tristanlee85/canode/validation/reports/2026-11-09_sim.md

# Step 6: Analog simulation (2026-11-09)

> **Update (same day):** T approved the protection redesign, and it is now on the board: SMCJ33A, R17 10 Ω + C1 10 µF, R18 2.2 Ω. Results for the board as it now stands are the `*_new` cases in `run_all.py`, written up in [`2026-11-09_protection.md`](2026-11-09_protection.md). This report describes rev A *before* that change. One correction to it: the TI LDO model's internal ~1 µF input capacitor flattered the "SMBJ33A" pulse-2a rows below. That is why the SMC part was chosen.

**Result: FAIL on load dump, CONCERN on reverse battery, PASS on the divider and LDO start-up.**
The main problem is not the 30 V PTC or the 30 V FET. It is **D3 (SMBJ24A)**: its breakdown (26.7–29.5 V)
sits below the 35 V suppressed load dump that modern cars present, so it tries to clamp that dump and
takes 16–49 J, several times what an SMB package can absorb. Raising D3's breakdown fixes that, but
it pushes the transient clamp voltage up, and then Q1, the Schottkys and the LDO need more headroom.
See [Recommendations](#recommendations).

What was simulated is **rev A as committed** (`hardware/generator/design.py` at `0b6a452`). The
working-tree schematic already has Q1 = AO3422 (55 V) and D7 = SS36 (uncommitted, made by someone
else); the 55 V-FET what-ifs below cover that change.

## Verdicts

| # | Simulation | Verdict | Why |
|---|---|---|---|
| 1 | Reverse battery (−14 V) | **CONCERN** | D1 blocks (VIN −0.06 V), MCU pins are safe and F1 sees only 13.2 V once tripped. Two marginal points: the fault current of 39 A (43 A from a stiff source) is at or over F1's 40 A Imax, and **Q1's body diode carries 14.6 A / 20 W / 114 mJ via D7** until F1 trips, against a 2 A rating. |
| 2a | Load dump, unsuppressed (87 V / 1 Ω, 300 ms) | **FAIL** | VIN 48.8 V (above the LDO's 45 V abs max for 7 ms); D3 gets 3–9× its energy allowance; **F1 blocks 55–84 V for ~290 ms (2.8× its 30 V rating)**; Q1 avalanches (up to 61 W with a 24 Ω load); PA1 reaches 7.9 V (above the 7.3 V abs max). No SMB-class part survives this. |
| 2b | Load dump, suppressed (35 V clamp, Ri 0.5–4 Ω, 400 ms) | **FAIL** (D3) | D3 conducts 1.4–5.3 A, 40–163 W, **16–49 J, 1.1–3.7× even an optimistic SMB allowance.** F1 sees ≤ 8 V (PASS). Q1 VDS 30.6–31.6 V for up to 400 ms (**+5 % over its rating**, CONCERN). LDO 31.5 V (PASS). |
| 3 | VBAT divider | **PASS** | Gain 0.09089 (1/11), 0.5 LSB settling in 7.3 ms. PA0 ≤ 2.9 V in every survivable case. In test A only, PA0 reaches 4.3 V (above VDD + 0.3 V but within the FT-pin limits; the reading saturates). The AUX_IN copy of the divider has no TVS: see sim 2a. |
| 4 | LDO start-up (TI model, real caps) | **PASS** | +3V3 rises to 3.0 V in 79 µs with no overshoot. Hot-plug ringing reaches 16.4 V. Inrush peaks at 8.6 A for µs. Regulation holds through a 4.5 V crank dip. |
| + | ISO 7637-2 pulse 2a, 112 V / 2 Ω (supplementary) | **CONCERN** | As built, VIN reaches 44.3 V: above the LDO's 40 V operating limit and 0.7 V under its 45 V abs max. D2 (SS34, 40 V) sees about 44 V reverse. Run because it decides the TVS choice. |

### The question asked: are the 30 V PTC and FET exposed above their rating?

| Event | F1 PTC (30 V, Imax 40 A) | Q1 AO3400A (30 V, no avalanche rating) |
|---|---|---|
| Reverse battery −14 V | **No.** 13.2 V across F1 after trip. But Imax is the issue: 39.3 A peak from a 50 mΩ source, 43.2 A from 20 mΩ (8 % over). | **No overvoltage**, but its body diode sits in parallel with D3's forward path (via D7): 14.6 A peak, 20 W, 114 mJ for about 12 ms. That pulse is unrated. |
| Suppressed load dump (35 V) | **No.** At most 8.1 V across it, because D3 holds VBATF at about 28–31 V. *This is only true while D3 survives.* If D3 fails short (likely, see 2b), F1 trips and blocks the full 35 V: **+17 %**. | **Yes, by 0.6–1.6 V (+2–5 %)** for up to 400 ms: VDS = VBATF + V(D7) = 30.6–31.6 V. That is leakage-level unless BVDSS is near 31 V (then 0.15 J of avalanche). |
| Unsuppressed load dump (87 V) | **Yes, by 2.8×.** After tripping (2.7–8.6 ms) it blocks **55–84 V for about 290 ms**. | **Yes.** It avalanches at its BVDSS (34 V assumed) while VBATF is at 49 V. With a 24 Ω load: 1.8 A, 61 W peak, and > 30 V for the whole 300 ms. |

So the 30 V parts are only *grossly* exceeded in the unsuppressed dump, which no SMB-size design
survives anyway. In the suppressed dump, the one these cars actually present, Q1 is marginal (+5 %) and F1 is
fine *only because D3 is absorbing energy it cannot survive*.

## Setup

- `ngspice-47`, run in PSpice-compatibility mode (`-D ngbehavior=ps`), plus numpy and matplotlib.
- **Files** (all in `validation/sim/`):
  - `run_all.py`: runs every sim and prints the numbers. It also writes `out/summary.txt` and `out/sim*.png`.
  - `fetch_models.sh`: downloads the vendor models and checks each against a pinned sha256.
  - `board.inc`: rev A's power, sense and AUX netlist, transcribed from `design.py`.
  - `models.inc`, `models/canode.lib`: local derived and behavioral models.
  - Top-level netlists: `reverse_battery.cir`, `loaddump.cir`, `vbat_divider.cir`, `ldo_startup.cir`.
- **To run:** `source .venv/bin/activate && python validation/sim/run_all.py` (about 15 s).
  The raw `.dat` files total about 175 MB and are gitignored; PNGs and `summary.txt` are kept.
- **Vendor models are not committed.** TI marks its model "All rights reserved"; Vishay's carry a Thomatronik copyright with no redistribution grant. `.gitignore` excludes `validation/sim/models/vendor/`. I read each file before pinning its hash: all are plain `.SUBCKT`/`.MODEL` text with no `.control` blocks.

### Models and where they came from

| Part | Model | Source / approximation |
|---|---|---|
| U2 TPS7B6933-Q1 | **TI unencrypted PSpice transient model** `TPS7B6933-Q1_TRANS.lib` (WEBENCH, Dec 2014, "Final 1.00"), used unmodified | [ti.com/lit/zip/slvmcq7](https://www.ti.com/lit/zip/slvmcq7). Runs as-is in ngspice's PSpice mode. **It is behavioral**: no loop dynamics (so it can't check stability; that was checked against the datasheet instead), no thermal shutdown, no abs-max behavior, and dropout is modeled as a 4.66 Ω switch. Its UVLO is 4.0 V on / 3.0 V off; the datasheet says 3.65 V max rising and 3 V falling. |
| D1, D2, D7 SS34 | Vishay `ss34.txt` (Thomatronik), BV 44 V | [vishay.com/docs/88170/ss34.txt](https://www.vishay.com/docs/88170/ss34.txt) |
| D3 SMBJ24A | **Derived.** Vishay publishes SMBJ22A/30A/33A/36A models but not 24A. I used the same Thomatronik topology (`SMBJ_UNI` in `canode.lib`) refit to the SMBJ24A datasheet: VBR 28.1 V nominal (26.7–29.5), Rd = (38.9 − 28.1)/15.4 = 0.70 Ω | Vishay fit its own models the same way. Validation: `SMBJ_UNI` reproduces Vishay's SMBJ22A to 0.01 V and SMBJ33A to 0.07 V from 1 mA to IPP; the 24A fit gives 39.0 V at 15.4 A (datasheet 38.9 V). No self-heating: real VBR rises about 0.1 %/K during long pulses, so the long-pulse numbers slightly understate VBATF. |
| SMBJ33A / 36A (what-if) | Same subckt with Vishay's parameters (38.65 V / 1.30 Ω, 42.1 V / 1.54 Ω) | [smbj33a.txt](https://www.vishay.com/docs/88150/smbj33a.txt), [smbj36a.txt](https://www.vishay.com/docs/89579/smbj36a.txt) |
| Q1 AO3400A | **Fitted ngspice VDMOS.** AOS publishes no SPICE model. Fitted to the AOS datasheet (Rev 3.1, Jul 2023): Vth 1.05 V, 19 mΩ at 4.5 V, VSD 0.7 V at 1 A, Ciss/Coss/Crss, Rg 3 Ω | The datasheet gives only BVDSS ≥ 30 V and **no avalanche (EAS/IAS) rating**. I assumed **34 V** for the body-diode breakdown and ran a 31 V corner. For the 55 V what-if, `NFET_55V_OFF` is the same model with BV 58 V; it is not a fit of the AO3422. |
| F1 BSMD1206-050-30V | **Thermal behavioral PTC** (one RC, T in °C). R(T) = 0.25 Ω × (1 + ΔT/40) plus a polymer switch near 115–125 °C. Rth = 125 K/W, so the tripped state dissipates 0.8 W (the catalog Pd). | No vendor model, and the PDF datasheet couldn't be downloaded. Specs are from the LCSC/JLC listing: Ihold 0.5 A, Itrip 1 A, 30 V, Imax 40 A, Pd 0.8 W, R 0.15–0.85 Ω, trip ≤ 0.1 s (test current not printed; 8 A, the industry standard for this size, assumed). Calibrated corners: **slow** trips in 94.6 ms at 8 A (the datasheet maximum); **fast** trips in 29.7 ms. Both hold at 0.5 A (+10 K) and trip at 1 A. Arcing or breakdown above Vmax is not modeled. |
| PA0 / PA1 | Diode to VSS only, plus 5 pF | ST says positive injection is not possible on FT pins. Limits used: abs max VDDIO + 4.0 V = 7.3 V; normal operation ≤ min(VDD + 3.6 V, 5.5 V); negative injection −5 mA. Sources: the STM32G0B1/G0C1 datasheet tables (via the G0C1 text and an ST community answer; the G0B1 PDF wouldn't download). **Verify in DS13560 that PA0 and PA1 are FT_xx.** |
| Passives | Effective values after DC-bias derating: C1 0.8 µF; +3V3 total 11 µF (16.4 µF nominal); +3V3 load 165 Ω (about 20 mA) plus the power LED | From `design.py` part numbers |

### Model fixes and simulator limits (stated so they can be reproduced)

- **Run end times.** Each load-dump run stops 5 ms after its pulse ends. In unsuppressed cases with no AUX load, the board browns out behind the tripped PTC: the LDO hiccups in UVLO, which is physical (the PTC needs seconds to cool and reset). After the pulse, the TI model's ideal UVLO comparator makes the timestep collapse. Recovery isn't needed for any of the metrics. `run_all.py` now **fails loudly** if any run aborts. Earlier silent truncation was caught and fixed this way.
- **USB start-up edge.** The USB start-up uses a 100 µs VBUS edge. With a 1–5 µs edge, the TI model's internal 1 µF (behind its UVLO switch) charge-shares with C1, VIN dips back under UVLO, and the comparator chatters until ngspice aborts. That is a model artifact.
- **Rejected model patch.** I tried shrinking that internal capacitor to 10 nF in a working copy. It fixed the chatter but made the model pump VIN to 75 V during brown-out, which is not physical, so I reverted it. The vendor model is used exactly as published.
- **What the model can't check.** It has no IN-pin abs-max behavior. The LDO's input exposure is therefore reported as the VIN voltage versus the datasheet limits: **40 V operating, 45 V abs max, "withstands 45 V for 200 ms"** (SLVSCJ8B, verified).

## Sim 1: reverse battery

**Model.** At t = 1 ms, −14 V is applied at J2-1 from a 50 mΩ source (battery plus harness) through 1 µH. AUX_IN is wired to the same reversed feed. Cases: no AUX load, an 85 Ω / 0.2 H relay, a 12 Ω lamp, a stiff 20 mΩ source, the fast PTC corner, and a what-if with 2.2 Ω in series with D7. Plot: `out/sim1_reverse_battery.png`.

| | F1 peak | Trip after reversal | I²t | D3 forward | Q1 body diode (via D7) | F1 after trip |
|---|---|---|---|---|---|---|
| Slow PTC (worst) | **39.3 A** | 12.3 ms | 6.0 A²s | 24.7 A, 0.29 J | **14.6 A, 20 W, 114 mJ** | 13.2 V, 58 mA |
| Fast PTC | 39.0 A | 3.9 ms | 1.9 A²s | 24.5 A, 0.10 J | 14.5 A, 36 mJ | 13.2 V |
| Stiff source (20 mΩ) | **43.2 A** (> 40 A Imax) | 11.1 ms | 6.0 A²s | 27.0 A | 16.3 A, 23.5 W | 13.2 V |
| 12 Ω lamp on AUX_OUT | 39.1 A | 12.5 ms | | 24.9 A | 15.1 A, then **1.11 A continuous** (lamp current; about 0.9 W in Q1 indefinitely) | 13.0 V |
| What-if: 2.2 Ω in series with D7 | 37.8 A | 12.9 ms | | 37.0 A, 0.56 J | **0.74 A, 4 mJ** | 13.1 V |

**Minimum voltages** (slow corner):

| Node | Minimum | Assessment |
|---|---|---|
| VBATF | −2.16 V | D3's forward drop at 25 A |
| VIN | −0.06 V | D1 blocks; the LDO's abs min is −0.3 V |
| +3V3 | 0 V | |
| PA0 | −0.16 V | |
| PA1 | −0.59 V | Clamped by the pin diode with −0.13 mA injected, within the −5 mA limit |
| AUX_OUT | −1.39 V | Q1 body diode |

**Assessment.**
- Everything the plan asked about passes: D1 blocks, D3 conducts within its ratings (IFSM 100 A), F1 trips in 4–12 ms, and nothing on the MCU side goes below −0.5 V except PA1, which is within its injection limit.
- Two concerns remain.
  - **F1's 40 A Imax is reached or exceeded.** The fault current is set only by the source and harness resistance plus F1's own 0.25 Ω.
  - **Q1's body diode and D7 form a second reverse path** in parallel with D3's forward drop, because VBATF sits 2.2 V below ground. A 2.2 Ω resistor in series with D7 cuts that path to 0.74 A. It costs +0.3 V on normal relay flyback (simulated: VDS 14.1 V vs 13.8 V).

## Sim 2: load dump (Q1 off)

**Model.**
- **Generator:** 13.5 V baseline stepping to US through Ri. The "vehicle bus" node after Ri feeds J2-1 (20 mΩ + 1 µH), AUX_IN, and the external AUX_OUT load.
- **Test A** (unsuppressed): 87 V / 1 Ω, flat top for 300 ms (the plan's worst case), plus an ISO-like shape (10 ms rise, decaying to 10 % at 300 ms).
- **Test B** (suppressed, ISO 16750-2): the same pulse clamped to Us* = 35 V before Ri, with Ri = 0.5 / 1 / 4 Ω and 400 ms (the longest td).
- **TVS rating comparison:** 600 W for 10/1000 µs equals 0.87 J over an equivalent 1.44 ms. For longer pulses the allowance is scaled with √t (adiabatic). That is an optimistic extrapolation of the datasheet Ppk–td curve beyond 10 ms (SMBJ steady-state dissipation is only a few watts), so exceeding it is a clear fail and staying under it is not proof of survival.
- **Plots:** `out/sim2_loaddump_unsuppressed.png`, `out/sim2_loaddump_suppressed.png`.

### Test A: unsuppressed

| Case | VBATF pk | VIN pk (> 45 V) | F1: Ipk / trip / V blocked | D3: Ppk / E / vs allowance | Q1 VDS (Id) | PA0 / PA1 |
|---|---|---|---|---|---|---|
| Flat, slow PTC | 49.1 V | **48.8 V (7.1 ms)** | 30.3 A / 8.6 ms / **83.8 V for 292 ms** | 1461 W / 10.7 J / **5.5×** | 34.0 V (µA) | 4.28 / **7.91 V** |
| Flat, fast PTC | 49.0 V | 48.8 V (2.2 ms) | 30.2 A / 2.7 ms / 83.8 V | 1457 W / 3.4 J / **3.1×** | 34.0 V | 4.01 / 7.91 V |
| ISO shape | 47.7 V | 47.5 V (1.4 ms) | 27.9 A / 19.4 ms / 42.3 V | 1330 W / 13.0 J / **5.8×** | 33.9 V | 4.17 / 6.38 V |
| + 85 Ω relay on AUX_OUT | 49.1 V | 48.8 V | 30.2 A / 8.6 ms / 57.7 V | 16.3 J / **6.8×** | 34.2 V, 0.33 A, 11 W | |
| + 24 Ω load on AUX_OUT | 48.7 V | 48.5 V | 29.7 A / 8.9 ms / 54.9 V | 30.5 J / **9.2×** | 34.3 V for 300 ms, 1.8 A, **61 W** | |
| What-if D3 = SMBJ33A | 63.1 V | **62.9 V (21 ms)** | 19.7 A / 20 ms / 83.8 V | 21.6 J / 7.0× | 34.0 V | **5.66 V** / 7.91 V |

Note the AUX_OUT load cases. Once F1 trips, the **external load plus D7 form an unfused path from the
bus into VBATF and D3**. F1 does not protect D3 when something is wired to AUX_OUT, which is why D3's
energy doubles or triples.

A hand calculation for what a real test-A clamp would have to absorb: 87 V, Ri 1 Ω, the ISO shape
with td 300 ms, into a 35 V clamp, comes to about **120 J**. That is DO-218 load-dump-TVS territory or
an active surge stopper, not an SMB.

### Test B: suppressed (35 V)

| Case | VBATF pk | VIN pk | F1: Ipk / trip / V across | D3: I / Ppk / E / vs allowance | Q1 VDS (time > 30 V) |
|---|---|---|---|---|---|
| Ri 0.5 Ω, slow PTC | 31.4 V | 31.5 V | 4.7 A / 394 ms / 5.4 V | 4.6 A / 146 W / **48 J / 3.7×** | **31.4 V (392 ms)** |
| Ri 0.5 Ω, fast PTC | 31.5 V | 31.5 V | 4.7 A / 123 ms / 6.7 V | 146 W / 15.9 J / **2.1×** | 31.4 V (123 ms) |
| Ri 1 Ω | 30.6 V | 30.6 V | 3.5 A / no trip / 1.7 V | 106 W / 39 J / **2.8×** | 30.6 V (399 ms) |
| Ri 4 Ω | 29.2 V | 29.6 V | 1.4 A / no trip / 0.4 V | 40 W / 15.7 J / **1.1×** | 29.1 V |
| D3 at VBR min (26.7 V) | 31.0 V | 31.1 V | 5.3 A / 297 ms / 8.1 V | 163 W / 41.5 J / 3.6× | 30.9 V (250 ms) |
| + relay on AUX_OUT | 31.4 V | 31.5 V | 4.7 A / 397 ms / 4.7 V | 48.6 J / 3.7× | 31.6 V (397 ms) |
| + relay, Q1 BVDSS 31 V | 31.5 V | 31.5 V | | 48.5 J | 31.1 V, avalanche 0.7 W, 0.15 J |
| **What-if D3 = SMBJ33A** (+ relay) | 35.3 V | 36.0 V | 1.0 A (board only) / no trip / 0.3 V | **0 A** | 34.1 V: AO3400A avalanches (0.14 J) |
| **What-if SMBJ33A + 55 V FET** | 35.0 V | 34.8 V | no trip | **0 A** | 35.1 V, no avalanche |
| What-if D3 = SMBJ36A | 35.3 V | 36.0 V | no trip | 0 A | 34.1 V |

Across the whole ISO Ri range (0.5–4 Ω), SMBJ24A takes 16–49 J during a 35 V suppressed dump, and
**the PTC doesn't save it**: at Ri ≥ 1 Ω the PTC never trips within 400 ms. With D3's breakdown above
35 V (SMBJ33A or 36A), D3 carries nothing, F1 doesn't trip, VIN stays at 36 V (within the LDO's 40 V
operating limit), and only Q1 needs more than 35 V of rating.

### Supplementary: ISO 7637-2 pulse 2a (+112 V on 13.5 V, Ri 2 Ω, tr 1 µs, td 50 µs)

| Case | VBATF pk | VIN pk | Q1 VDS | +3V3 max |
|---|---|---|---|---|
| As built (SMBJ24A) | 44.8 V | **44.3 V** (> 40 V operating, 0.7 V under the 45 V abs max) | 34.1 V (AO3400A at BV, µs) | 3.62 V |
| As built, 55 V FET, relay | 44.8 V | 44.3 V | 42.9 V | |
| D3 = SMBJ33A | 54.0 V | **53.6 V (> 45 V abs max)** | | 3.69 V |
| SMBJ33A + 55 V FET, relay | 54.0 V | 53.6 V | **53.8 V (2 % under 55 V)** | |
| SMBJ33A + 10 Ω (D1→VIN) + C1 = 8 µF effective | 61.5 V | **23.6 V** | VBATF + Vf ≈ 62 V | 3.37 V |
| 50 V level, as built | 33.2 V | 32.7 V | 31.6 V | |

D3 energy is negligible in every row (≤ 0.02 J). What matters is the clamp *voltage*. Raising D3's
breakdown to clear 35 V puts about 54 V on VBATF and VIN at the harshest 2a level. The +3V3 bumps come
from the TI model's behavioral PSRR (indicative only; the STM32's VDD abs max is 4.0 V). As built,
**D2 (SS34, 40 V) is reverse-biased to about 44 V** (VIN against an unpowered VBUS), and the same
applies to D7 when Q1 is on.

## Sim 3: VBAT divider

**Model.** The board netlist with an ideal supply on VBAT_IN, so F1's drop is included. A DC sweep from 0 to 26 V (above that, D3 conducts and a DC sweep stops being meaningful), plus a 0 → 14 V step. Plot: `out/sim3_vbat_divider.png`.

| VBAT | 9 V | 12 V | 13.5 V | 14.4 V | 16 V | 24 V |
|---|---|---|---|---|---|---|
| PA0 (V) | 0.818 | 1.090 | 1.227 | 1.309 | 1.454 | 2.181 |
| ADC code (3.3 V ref) | 1015 | 1353 | 1523 | 1624 | 1805 | 2707 |

- **Gain:** 0.09089 (ideal 1/11 = 0.09091; the difference is F1's drop at 20 mA).
- **Settling:** τ = 9.09 kΩ × 100 nF, 0.91 ms (63 % in 0.91 ms, simulated). **0.5 LSB in 7.3 ms.**
- **ADC kickback:** with a 100 nF hold cap, the ADC's ~5 pF sampling cap disturbs the input by < 0.2 LSB, so any sampling time works.

**Peak PA0 and PA1 during the load-dump runs:**

| Event | PA0 (VBAT) | PA1 (AUX_IN on the bus) |
|---|---|---|
| Test B, any case | **2.86 V**, under VDD | 3.1–3.2 V |
| Test B with D3 = SMBJ33A | 3.18 V (35 V reads about 3950 counts, still in range) | 3.18 V |
| Test A | 4.0–4.3 V: above VDD + 0.3 = 3.6 V, below the 5.5 V operating and 7.3 V abs-max limits; reading saturates above 36.3 V | **7.9 V > 7.3 V abs max.** AUX_IN has no TVS; 9.1 kΩ Thevenin limits it to < 0.5 mA, but FT pins don't allow positive injection, so the pin voltage just rises |
| Pulse 2a | ≤ 1.37 V | ≤ 1.37 V (filtered by the 100 nF) |

**Verdict: PASS** for the VBAT divider, including VDD + 0.3 V in every survivable event. Test A is
the only exceedance, and the board doesn't survive test A anyway.

## Sim 4: LDO start-up (TI model, real caps)

| Case | VIN pk | Inrush pk | +3V3: 10–90 % / to 3.0 V | +3V3 max | Notes |
|---|---|---|---|---|---|
| 12 V hot-plug, 1 µH lead | 15.7 V (VBATF 16.1 V) | 8.6 A (µs, C1/C2 through D1) | 67 µs / 79 µs | 3.308 V | No overshoot; ringing below D3's VBR |
| 12 V hot-plug, 3 µH lead | 16.4 V | 5.8 A | 67 µs / 80 µs | 3.308 V | |
| USB 5 V (100 µs edge) | 4.8 V | | 69 µs / 164 µs from start of edge | 3.301 V | VIN = VBUS − D2 = 4.76 V |
| 12 V slow ramp, 10 ms | 11.8 V | 0.93 A | starts at VBAT ≈ 4.3 V (3.57 ms) | 3.308 V | The model's UVLO is 4.0 V; the real part's is ≤ 3.65 V |
| Crank dip to 4.5 V, 30 ms | | | | min 3.300 V | VIN min 4.26 V. The datasheet's worst dropout (0.8 V at 50/100 mA) still leaves ≥ 3.3 V |
| Start-stop dip to 6.0 V | | | | min 3.302 V | |

- **Capacitors:** effective +3V3 capacitance is 11 µF (the datasheet needs 2.2–100 µF effective, ESR < 2 Ω) ✔. Input caps C1 + C2 are 1.1 µF nominal (the datasheet recommends > 0.1 µF) ✔.
- **Stability:** loop stability can't be simulated with this behavioral model; the datasheet requirements above are met.
- **Verdict: PASS.**

## Recommendations

Electrical requirements only; sourcing is being handled separately.

1. **Design target: ISO 16750-2 test B (35 V suppressed), not test A.**
   - Modern vehicles like the targets clamp load dump centrally. Test A would need about 120 J of clamping (DO-218-class load-dump TVS) and an F1 rated ≥ 100 V, or an active surge stopper / OV-disconnect with a ≥ 100 V series FET.
   - Say in the README that the board is not test-A rated.
2. **Change D3 now. This is the actual failure.**
   - **Requirement:** VBR(min) ≥ 36 V, so D3 doesn't conduct at 35 V, and standoff ≥ 26 V for jump-start (SMBJ24A sits right at its 24 V standoff during a 24 V jump).
   - **Candidate:** an SMBJ33A-class part (VBR 36.7 V min, VC 53.3 V at 11.3 A) meets this. Simulated: **0 A in test B** and only 0.01 J on pulse 2a.
   - Keep it unidirectional: the forward clamp is what handles reverse battery and negative pulses.
3. **Everything on VBATF, VIN and AUX_OUT must then handle about 54 V transients** (62 V if C1 is moved behind a series resistor) and 35 V DC for 400 ms:
   - **Q1:** VDS ≥ 60 V, preferably avalanche-rated (EAS specified). The 55 V AO3422 in the working tree is enough with SMBJ24A (42.9 V on pulse 2a), but has only 2 % margin with SMBJ33A (53.8 V). Separately, either the body diode must be rated for a ~15 A, 15 ms pulse, **or add 2.2 Ω (0805) in series with D7**, which cuts the reverse-battery current through Q1 from 14.6 A to 0.74 A.
   - **D1, D2, D7:** VRRM ≥ 60 V. D2 is already at 44 V reverse on pulse 2a as built. D7 → SS36 is already in the working tree; D2 needs the same.
   - **LDO**, either of:
     - (a) VIN abs max ≥ 60 V; or
     - (b) keep the TPS7B69 (40 V operating / 45 V abs) behind **10 Ω from D1 to VIN plus ≥ 8 µF effective at 35 V on VIN** (two 10 µF / 50 V 1210 X7R, or an electrolytic). Simulated VIN on pulse 2a: 23.6 V. Cost: 0.2–0.6 V of drop at 20–60 mA; the 4.5 V crank case still regulates.
     - In test B with SMBJ33A, VIN = 36 V, within 40 V either way.
4. **F1 to 60 V: lower priority than D3 and Q1, but cheap insurance.**
   - With D3 fixed per (2), F1 never trips from a load dump. Its worst voltage is then 13.2 V (reverse battery), so 30 V is technically enough.
   - Reasons to change it anyway:
     - A downstream short during a 35 V event puts 35 V across it.
     - Its **40 A Imax is reached in reverse battery** (39–43 A).
   - **Requirement:** Vmax ≥ 36 V minimum (60 V preferred), Imax ≥ 50 A, Ihold 0.5 A / Itrip ≈ 1 A.
5. **AUX_IN (optional):** fine for test B. To survive more, raise R13 or add a clamp at AUX_SENSE.
6. **Bottom line on "swap to 60 V parts now?"** Yes, for **Q1 and the Schottkys**, *together with* the D3 change. **On its own, swapping F1 and Q1 to 60 V while keeping SMBJ24A does not fix the real failure** (D3 overstress in the 35 V dump). Changing D3 alone, without the downstream ratings, moves the failure to Q1, D2 and the LDO on fast pulses.

## Proposed Makefile target (not added; Makefile is the lead's)

```make
sim:                           ## analog sims (ngspice) -> validation/sim/out/summary.txt + plots
	$(PY) validation/sim/run_all.py
```
(Add `sim` to `.PHONY`. Needs `ngspice` on PATH and numpy/matplotlib in the venv; the vendor models download on the first run. `make check` could include it; the run takes about 15 s.)
