tristanlee85/canode/validation/reports/2026-11-09_drc.md

# Step 4: Board DRC + schematic parity (2026-11-09)

**Result: PASS.** 0 errors, 0 unconnected pads, schematic parity clean.
51 warnings remain, all `lib_footprint_mismatch`, reviewed and left as-is (below).

Tool: KiCad 10.0.8 `kicad-cli pcb drc --severity-all --schematic-parity` (`make drc`).

## First run (before fixes)
| Type | Count | Severity | Outcome |
|---|---|---|---|
| `clearance` | 1 | error | **Fixed**: via moved |
| `starved_thermal` (U5 pin 2) | 1 | error | **Fixed**: solid zone connection |
| `silk_overlap` (C5 / Y1 reference text) | 1 | warning | **Fixed**: Y1 label moved |
| `net_conflict` | 199 | warning | **Fixed**: nets renamed to schematic names |
| `footprint_symbol_field_mismatch` | 20 | warning | **Fixed**: fields synced |
| `footprint_symbol_mismatch` (BOM flag) | 6 | warning | **Fixed**: intent set in schematic / board |
| `lib_footprint_mismatch` | 51 | warning | Left as-is |

The stored zone fill was current before any change: DRC with `--refill-zones` gave identical results.

## Changes made
All were tested on a scratch copy first, then applied. Afterwards: `make check` (pins 28/28, ERC 0 errors, DRC 0 errors, parity clean) and `make fab` (CPL identical to the committed rev A one, so no part moved).

1. **Clearance (0.157 mm, rule 0.2 mm):** GND stitching via (no tracks attached) next to the 0.5 mm VBATF track moved
   from (106, 133) to **(105.8, 132.8)**, giving ~0.37 mm clearance. Four other candidate positions were also clean.
2. **Starved thermal, U5 pin 2 (GND):** pad zone connection set to **solid**. Normal for a reflowed SOIC ground pin.
3. **Silk overlap:** Y1 reference label moved 2.2 mm left. (Trialled 7 positions; others hit pads or C6.)
4. **Format upgrade:** `kicad-cli sch|pcb|sym upgrade`. Schematic, board and project symbol library are now KiCad 10 format.
5. **Net names (`net_conflict`):** the generator named board nets `VIN`, `GND`, …; KiCad names local-label nets `/VIN`, ….
   All 45 board nets were renamed to the names in KiCad 10's own netlist export (every board net had an exact `/`-prefixed match).
   The 24 schematic no-connect pins got their `unconnected-(…)` net names via KiCad's Python API (`pcbnew`, bundled with KiCad 10).
6. **Net-class trap, fixed first:** the net-class patterns were exact names (`VBATF`, `VIN`, `GND`, …). Tested on a scratch copy:
   renaming VBATF to `/VBATF` made the pattern stop matching. VBATF silently fell back to the Default class (0.15 mm), and the
   clearance error *disappeared without being fixed*. So `/`-prefixed patterns were added for all seven power/supply nets
   in `canode.kicad_pro` (old ones kept). Verified: the clearance error still reported with the new names until the via was moved.
7. **Footprint fields:** Datasheet, LCSC, MPN and JLC fields copied from the symbols to the footprints (what F8 does), via `pcbnew`.
8. **BOM flags:** the board excluded J2–J5 and JP1/JP2 from the BOM; the schematic included all six. Resolved by intent:
   J2–J5 are real purchased connectors (now in BOM on both sides); JP1/JP2 are bare-copper solder jumpers with nothing to buy
   (schematic set to `in_bom no`). The JLC files are unaffected: `jlc_fab.py` selects assembled parts by the `LCSC` field.

Because of 5, 7 and 8, *Update PCB from Schematic* (F8) currently has nothing left to do.

## Warnings left as-is: `lib_footprint_mismatch` (51)
The board uses footprints embedded from the KiCad 7 libraries; KiCad 10's libraries have changed since. Same situation as the
symbols in the ERC report. **Don't run *Update Footprints from Library*** without first checking pad numbering and geometry
for each part.

## Fab output note
`make fab` output differs from the committed `hardware/fab/` only in descriptive text (the committed BOM / hand-solder files were
hand-tidied after generation, e.g. "Tactile switch" vs. the symbol value "RESET"). LCSC numbers, designators and the CPL are identical.
