tristanlee85/canode/validation/reports/2026-11-09_lcsc.md

# Step 9: LCSC / JLC stock and price, plus part-upgrade recommendations (2026-11-09)

**Result: ❌ NOT orderable as-is.** Three BOM lines have **0 stock** at both JLC and LCSC:
- **U1 STM32G0B1CBT6**
- **D3 SMBJ24A** (FMS, C143156)
- **D5 yellow LED** (C72038)

One more line is low: **U2 TPS7B6933QDCYRQ1, 59 pcs**.

D3 and D5 have easy drop-in replacements. U1 does not.

## How the data was gathered
- **JLC:** the JSON endpoints behind jlcpcb.com/parts. `selectSmtComponentList` gives library type (`base` = Basic, `expand` = Extended), the `preferredComponentFlag` and stock. `getComponentDetail` gives the brand, MPN and datasheet. Both were queried 2026-11-09.
- **LCSC:** `wmsc.lcsc.com/ftps/wm/product/detail`, which gives LCSC's own stock and price ladder.
- **Price @10:** JLC's 1–199 tier in USD, which is what JLC assembly charges per part.
- Neither site blocked these queries. Product pages: `https://www.lcsc.com/product-detail/<C#>.html`, `https://jlcpcb.com/parts/componentSearch?searchTxt=<C#>`.
- Stock changes daily, so re-check on the day you order.

## BOM lines
| Ref | Part (the actual MPN at that LCSC #) | LCSC # | JLC class | JLC stock | LCSC stock | $ @10 | Flag |
|---|---|---|---|---|---|---|---|
| C1 | Samsung CL21B105KBFNNNE 1 µF 50 V 0805 | C28323 | Basic | 4,125,668 | 506,100 | 0.0280 | |
| C2,C4,C5,C7,C9,C12–C14,C16,C17 | **YAGEO CC0603KRX7R9BB104** 100 nF 50 V X7R | C14663 | Basic | 33,392,876 | 67,800 | 0.0060 | BOM note says CL10B104KB8NNNC; the real part is an equivalent YAGEO. Fix the note. |
| C3 | **Samsung CL10A106MA8NRNC 10 µF 25 V** X5R 0603 | C96446 | Basic | 6,682,748 | 2,051,780 | 0.0346 | BOM note says CL10A106MQ8NNNC (6.3 V); the real part is rated 25 V, which is better. Fix the note. |
| C6, C15 | Samsung CL21A475KAQNNNE 4.7 µF 25 V X5R 0805 | C1779 | Basic | 1,745,984 | 199,740 | 0.0342 | |
| C8 | Samsung CL10A105KB8NNNC 1 µF 0603 | C15849 | Basic | 12,755,045 | 539,700 | 0.0109 | |
| C10, C11 | FH 0603CG300J500NT 30 pF C0G | C1658 | Basic | 395,734 | 90,800 | 0.0051 | Proposed change to 20 pF (step 7) |
| D1, D2, D7 | MDD SS34 | C8678 | Basic | 3,000,794 | 2,174,640 | 0.0351 | |
| **D3** | FMS SMBJ24A (uni) | C143156 | Extended | **0** | **0** | 0.0738 | ❌ **Out of stock** |
| D4 | KENTO KT-0805G green | C2297 | Basic | 1,929,972 | 1,037,200 | 0.0164 | |
| **D5** | Everlight 19-213/Y2C-CQ2R2L/3T yellow | C72038 | Extended | **0** | **0** | 0.0239 | ❌ **Out of stock**; also no longer Basic |
| D6 | KENTO KT-0603R red | C2286 | Basic | 6,532,831 | 4,019,600 | 0.0077 | |
| F1 | BHFUSE BSMD1206-050-30V | C883126 | Extended | 92,935 | 91,140 | 0.0599 | Upgrade proposed (30 V) |
| J1 | HRO TYPE-C-31-M-12 | C165948 | Extended | 311,218 | 291,175 | 0.1868 | |
| Q1 | AOS AO3400A | C20917 | Basic | 1,039,675 | 463,345 | 0.0889 | Upgrade proposed (30 V) |
| R1–R4 | UNI-ROYAL 0603WAF1001T5E 1k | C21190 | Basic | 26,494,446 | 1,246,700 | 0.0017 | |
| R5,R7,R12,R14 | 0603WAF1002T5E 10k | C25804 | Basic | 47,114,251 | 7,546,000 | 0.0022 | |
| R6, R8 | 0603WAF1200T5E 120 Ω | C22787 | Basic | 2,716,609 | 1,153,300 | 0.0020 | |
| R9, R10 | 0603WAF5101T5E 5.1k | C23186 | Basic | 20,185,962 | 14,985,600 | 0.0015 | |
| R11,R13,R16 | 0603WAF1003T5E 100k | C25803 | Basic | 16,051,870 | 7,021,900 | 0.0029 | |
| R15 | 0603WAF1000T5E 100 Ω | C22775 | Basic | 9,243,563 | 810,700 | 0.0020 | |
| SW1, SW2 | XKB TS-1187A-B-A-B | C318884 | Basic | 851,960 | 672,080 | 0.0207 | |
| **U1** | ST STM32G0B1CBT6 | C2847904 | Extended | **0** | **0** | 7.5864 | ❌ **Out of stock.** JLC shows a pre-order backlog (`canPresaleNumber` −913) and no ETA. |
| **U2** | TI TPS7B6933QDCYRQ1 | C108471 | Extended | **59** | 59 | 0.5202 | ⚠ **Low stock.** You need 2. JLC's pre-order count is −46, so some may be spoken for (UNVERIFIED). |
| U3, U5 | TI SN65HVD230DR | C12084 | **Extended (Preferred)** | 108,450 | 63,957 | 0.4613 | Preferred: no extended-part fee on Economic |
| U4, U6 | onsemi NUP2105LT1G | C14486 | Extended | 173,147 | 173,055 | 0.0827 | |
| U7 | ST USBLC6-2SC6 | C7519 | Extended | 38,760 | 33,760 | 0.1623 | |
| Y1 | YXC X322512MSB4SI 12 MHz, CL 20 pF | C9002 | Basic | 239,570 | 95,865 | 0.0954 | |
| J2 (hand-solder) | Molex 43045-0812 | C277661 | Extended (not placed) | 18,070 | — | 0.4891 | Can be bought from LCSC with the order |

None of the parts are flagged obsolete or not-recommended in the JLC/LCSC data. JLC reports `componentStatus: yes` for all of them.

## Extended-part count
- **8 fee-bearing Extended lines:** D3, D5, F1, J1, U1, U2, U4/U6, U7.
- **1 Preferred Extended line:** U3/U5.
- JLC's prototype-assembly page says Preferred Extended parts are fee-free on Economic PCBA (https://jlcpcb.com/solutions/pcb-prototype-assembly, https://jlcpcb.com/help/article/pcb-assembly-faqs).
- At $3 each that's **$24**.
- One third-party source says JLC cut the fee to about $1.50 per part type in Dec 2025 (https://techoverflow.net/2024/04/09/jlcpcb-pcba-assembly-price-overview/). UNVERIFIED; the live quote is authoritative.

With the swaps recommended below, the count stays at **8**: D5 drops out as Basic, and Q1 becomes Extended.

## Stock risks and fixes

### U1 STM32G0B1CBT6: blocker, no drop-in at JLC/LCSC
Every JLC/LCSC listing of the 48-pin G0B1/G0C1 in the GP pinout shows **0 stock** in LQFP-48:
- STM32G0B1CBT6 (C2847904)
- STM32G0B1CCT6 (C5270241)
- STM32G0B1CET6 (C5270267)
- STM32G0C1CET6 (C3029185)

The **…T6N** listings (C5270160, C2978903, C3227066) also show 0, and they **would not be drop-ins anyway**. DS13560 gives separate "GP" and "N" pinouts; for example LQFP48 pin 30 is PC6 on GP parts and VSS on N parts.

Options, from least to most disruptive:
1. **Re-check on order day, or pre-order through JLC.** No ETA is given.
2. **Buy it elsewhere** (DigiKey/Mouser/ST) and consign it to JLC through its parts-consignment flow. Distributor stock and whether consignment works with *Economic* PCBA are both **UNVERIFIED**.
3. **STM32G0B1CEU6, UFQFPN-48, 512 KB** (C2829190, Extended, JLC stock 495, $5.26). Same GP pin numbering as LQFP48 (DS13560 pin table has a shared "LQFP48 / UFQFPN48 – GP" column), so firmware and the netlist stay the same. It **needs a new footprint and re-routing around U1**, and how to connect the exposed pad must be checked in DS13560. This is a layout change, T's call. (STM32G0B1CBU6, C5270156, has only 6 in stock.)
4. LQFP-64 STM32G0B1RBT6 (C5143679, 1,078 stock, $2.95). Different package and pin numbers, so it's a big change. Not recommended.

### D3 SMBJ24A: drop-in replacements (all SMBJ24A are Extended, so the fee is unchanged)
| Candidate | LCSC # | Class | JLC stock | $ @10 | Notes |
|---|---|---|---|---|---|
| **MDD SMBJ24A** | **C123819** | Extended | 50,032 | 0.0589 | Unidirectional, VRWM 24 V, VC 38.9 V, SMB. Same maker as the SS34. **Recommended.** |
| Littelfuse SMBJ24A | C224017 | Extended | 15,985 | 0.1198 | Unidirectional; well-known maker |

Both are unidirectional SMB (DO-214AA) parts with the band on the cathode, so they're footprint and polarity drop-ins. The polarity marking was checked on the FMS datasheet; for these two it is UNVERIFIED by image but standard for the SMBJ series. Don't pick an SMBJ24**CA** (bidirectional).

### D5 yellow LED: drop-in replacements
| Candidate | LCSC # | Class | JLC stock | $ @10 | Notes |
|---|---|---|---|---|---|
| **KENTO KT-0603W (white)** | **C2290** | **Basic** | 2,098,660 | 0.0123 | Vf 2.6–3.1 V. Through R3 = 1k from 3.3 V that's only about 0.2–0.7 mA: dim but visible (360 mcd at 5 mA). Optionally drop R3 to 330 Ω (C23138, not checked). |
| KENTO KT-0603R (red, same as D6) | C2286 | Basic | 6,532,831 | 0.0077 | Simplest option, but D5 and D6 would be the same colour |
| KENTO KT-0603Y (yellow) | C2287 | Extended | 87,339 | 0.0106 | Keeps the colour, but adds an Extended fee |

All three use the same KENTO drawing: the mark sits on terminal ② (cathode). See the footprint report: check the mark against the GND pad in JLC's preview.

### U2 TPS7B6933QDCYRQ1: low stock (59)
- No drop-in SOT-223 alternative exists at JLC.
- The DBV (SOT-23-5) variants are in stock but are not footprint-compatible:
  - TPS7B6933QDBVRQ1, C781801: 1,851 pcs.
  - TPS7B6933DBVR, C527569: 1,353 pcs.
- Action: order soon after finalising, or keep the DBV part as a rev-B fallback.

---

## Part upgrades for the known open issues (recommendations only; T decides)

### 1. F1: PTC rated 30 V, below the ≈ 39 V TVS clamp
I found **no 1206 resettable fuse rated ≥ 60 V at ~0.5 A hold** at JLC. The smallest 60 V/0.5 A PTCs are 1812.

| Option | Part | LCSC # | Class | JLC stock | $ @10 | Key specs | Drop-in? |
|---|---|---|---|---|---|---|---|
| **A: one-time fuse, same pads** | Littelfuse **0466.500NRHF** | **C151133** | Extended | 223,487 | 0.0719 | 1206, 0.5 A, **63 V**, 50 A breaking capacity, very fast-acting, non-resettable | **Yes** (Fuse_1206 pads) |
| B: resettable, 1812 | TECHFUSE mSMD050-60V | C70113 | Extended | 217,791 | 0.0877 | 1812, I_hold 0.5 A, I_trip 1 A, **60 V**, I_max 100 A | **No.** Needs `Fuse_1812_4532Metric` (about 4.5 × 3.2 mm) and about 1.3 mm more space next to J2/D3 |
| B′: resettable, 1812, same maker as today | BHFUSE BSMD1812-050-60V | C883142 | Extended | 36,883 | 0.0889 | 1812, 0.5 A / 1 A, 60 V, I_max 40 A | No (1812) |

Context on what F1 actually has to do:
- F1 carries only the board's own supply current (tens of mA). The AUX_OUT load current returns through J2 pin 8, Q1 and GND; it never passes through F1.
- F1's real job is to open when D3 crowbars, i.e. during a reverse battery or a sustained overvoltage.
- A tripped PTC only sees the full source voltage if something downstream is shorted. So the 30 V rating matters in combined-fault cases (sustained >30 V plus a downstream short), not in normal clamping.

**Recommendation:**
- If T is touching the layout anyway (the board is being edited now), use **B (C70113, 1812 60 V PTC)**. It keeps the resettable behaviour the design intends.
- If no layout change is wanted, use **A (C151133)**. It is a true drop-in with a 63 V / 50 A rating. The cost: a reverse-polarity hookup blows it, and fixing that means replacing a 1206 part.
- Either is better than the 30 V part for a permanent install.

### 2. Q1: AO3400A is 30 V
Need: N-channel MOSFET, 40–60 V, SOT-23, same G-S-D pinout, guaranteed on at 3.3 V gate, ≥ 1 A.

**No Basic part qualifies.** The only Basic 60 V SOT-23 FET is the 2N7002 (C8545, 115 mA, 5 Ω), which is far too weak.

| Candidate | LCSC # | Class | JLC stock | $ @10 | Vds | Rds(on) guarantee | Vgs(th) max | Id | Drop-in |
|---|---|---|---|---|---|---|---|---|---|
| **AOS AO3422** | **C37130** | Extended | 69,993 | 0.1409 | **55 V** | **≤ 200 mΩ at Vgs = 2.5 V, 1.5 A**; ≤ 160 mΩ at 4.5 V | 2.0 V | 2.1 A (25 °C), 1.7 A (70 °C) | **Yes.** Same AOS SOT-23 drawing as the AO3400A (pin-1 dot = G, so 1 G / 2 S / 3 D); VGS ±12 V. Datasheet: https://datasheet.lcsc.com/datasheet/pdf/547998f2f8f843ac8eb5f14f9ff477ce.pdf?productCode=C37130 |
| Winsok WST6066A | C148352 | Extended | 1,275 | 0.1762 | 60 V | ≤ 120 mΩ at 2.5 V, 1.5 A | 2.5 V | 2.1 A | Pinout not checked (UNVERIFIED); low stock |
| Vishay SI2356DS-T1-GE3 | C74127 | Extended | 1,265 | 0.3541 | 40 V | ≤ 70 mΩ at 2.5 V | 1.5 V | 3.6 A | 40 V is too close to the 39 V clamp; low stock |

Rejected:
- **DMN6140L, SI2308, NCE6003Y and CJ2310:** Rds(on) is specified only at ≥ 4.5 V and/or Vgs(th) can be up to 3 V, so they're not guaranteed on at 3.3 V.
- **NTR5198NL:** Vth max is 2.5 V and Rds(on) is specified only at 4.5 V.

**Recommendation: AO3422 (C37130).**
- At 3.3 V gate drive and 1 A it drops at most 0.2 V and dissipates at most 0.2 W, about a 25–30 °C rise (RθJA 115–150 °C/W).
- The cost is that Q1 goes from Basic to Extended, one more $3 line.

Side note: with Q1 fixed, **D7 (SS34, 40 V)** becomes the weakest part on AUX_OUT. When Q1 is on, D7 is reverse-biased by VBATF, up to about 39 V. **SS36** (MDD C16015, 60 V, Extended, 355,859 in stock, $0.039, SMA drop-in) would fix that, at the cost of another fee. It's optional.

### 3. D4 power-LED quiescent draw
- With the datasheet Vf (2.6–3.1 V at 5 mA) and R1 = 1k from 3.3 V, the real current is about **0.2–0.8 mA**, not the README's 1.3 mA. UNVERIFIED; measure it.
- The always-hot draw is dominated by the **MCU itself (about 8.6 mA typ at 64 MHz, DS13560 Table 28)** unless firmware uses Stop modes.

**Recommendation: raise R1 to 4.7k** (UNI-ROYAL 0603WAF4701T5E, **C23162, Basic**, 15.8 M in stock, $0.0028).
- About 0.1–0.17 mA, and the 430 mcd emerald part will still be visible.
- Zero layout change and zero fee.

Alternatives:
- Mark D4 **DNP** for permanent installs (0 mA, but no power indication).
- Moving the LED to a GPIO needs a schematic change. It only helps if the MCU sleeps, and then the LED is off anyway.

### 4. CAN-FD: do the target vehicles need it? **No. Don't swap now.**
The vehicle research came from a parallel web-research pass; each line shows its source and confidence.

| Vehicle | Buses this board would tap | FD? | Source / confidence |
|---|---|---|---|
| 2021 Bronco Sport (C2/CD542, Escape-based) | HS-CAN1–4 at ≤ 500 k, MS-CAN 125 k, behind the GWM | **No** | comma.ai opendbc lists the Bronco Sport 2021–24 and Escape 2020–22 as non-FD; the FD platforms are F-150 2021+, Mach-E, Escape 2023+ and others (https://raw.githubusercontent.com/commaai/opendbc/master/opendbc/car/ford/values.py), medium-high confidence. GWM bus layout from Ford's 2019 Ranger manual, a sister architecture (medium). Whether it is "FNV2", and which bus the start-stop module sits on: UNVERIFIED. |
| 2019 Silverado 3500 HD | HS-GMLAN 500 k (OBD 6/14); LS-GMLAN **single-wire** 33.3 k (OBD 1) | **No** | The 2019 HD is the last K2XX-body year (https://en.wikipedia.org/wiki/GMT_K2XX), so it's **Global A**. Global B/VIP (FD) started with the 2020 CT5/C8 and reached the 1500 trucks around MY2022.5 (https://gmauthority.com/blog/2019/08/cadillac-ct4-will-use-advanced-global-b-electrical-architecture; https://diag.net/discussion/sk90xwogkn4uahsgwb9015qcpz). High confidence for "no FD". |
| 2016 BMW F80 M3 | PT-CAN/PT-CAN2/K-CAN2/D-CAN 500 k; K-CAN 100 k **fault-tolerant low-speed**; FlexRay | **No** | BMW F01/F30 training docs (https://archive.org/download/BMWTechnicalTrainingDocuments/). High confidence for "no FD"; the K-CAN rate on F80 specifically is medium confidence. |

A gotcha that matters more than FD: the SN65HVD230, and every high-speed transceiver below, **can't** talk to GM LS-GMLAN (single-wire, SAE J2411) or BMW K-CAN (ISO 11898-3 fault-tolerant). Those buses would need a different transceiver (NCV7356 / TJA1055), which is out of scope.

**If FD headroom is wanted later, here's how the candidates compare to the SN65HVD230**, whose pin 5 is Vref and whose pin 8 Rs gives standby with the receiver still active:

| | **TCAN1044V(-Q1)** | TCAN3413 / TCAN3414 | **TCAN337G** |
|---|---|---|---|
| LCSC (SOIC-8) / JLC stock / $ @10 | C1852061 TCAN1044VDRQ1 / 2,671 / 0.36 | C22433320 / 9,433 / 0.90; C22396693 / 5,963 / 1.57 | C191004 TCAN337GDR / 914 / 1.63 |
| VCC (pin 3) | **4.5–5.5 V: the board has no 5 V rail** | 3.0–3.6 V ✅ | 3.0–3.6 V ✅ |
| Pin 5 | VIO (1.7–5.5 V): must be **wired to +3V3**; it's open today | 3413: VIO, must be wired to +3V3. 3414: SHDN (internal pull-down, can stay open) | **FAULT**: open-drain output, can stay open ✅ |
| Pin 8 | STB, active-high; internal pull-up | STB, active-high; internal pull-up | **S (silent)**, active-high; internal pull-down |
| What R5/R7 pulling pin 8 high does | Standby: the bus is safe, but RXD only reports a wake-up pattern, so you **can't sniff** | Same as TCAN1044V | **Silent: driver off, receiver fully active** (TCAN33x §6.4.3). Same "passive by default" behaviour as today, and it works as a full-rate listen-only mode |
| Firmware | STB low = normal. Listen-only then depends on FDCAN bus-monitoring mode alone | Same | Same polarity as today: PD2/PB2 low = normal, high = silent |
| FD rate | 8 Mbps | 8 Mbps | 5 Mbps |
| Bus-pin robustness | ±58 V | **±58 V standoff** | **±14 V** (weaker than the SN65HVD230's −4/+16 V) |
| Grade | AEC-Q100 (-Q1) | Industrial (the -Q1 TCAN340x SOIC versions show 0–1 at JLC) | Industrial |
| Drop-in on the current board? | **No** (needs a 5 V rail plus VIO wiring) | 3414: yes electrically, but loses the hardware listen-only mode. 3413: needs VIO wiring | **Yes**: same pads, same nets, same Rs/S polarity |

Datasheets: TCAN1044V https://www.ti.com/lit/ds/symlink/tcan1044v.pdf · TCAN341x https://www.ti.com/lit/ds/symlink/tcan3414.pdf · TCAN33x https://www.ti.com/lit/ds/symlink/tcan337.pdf

**Recommendation: don't swap for rev A.** None of the target cars use FD on the tappable buses. The SN65HVD230 is Preferred (no fee), is plentiful (108k in stock), and its Rs-high standby is already a hardware listen-only mode (step 7 report).

- **If FD is needed later:** TCAN337GDR is a drop-in that keeps the safety default. Its trade-offs are ±14 V bus pins and low stock.
- **For a hardened rev B:** TCAN3414DR (±58 V) is the stronger part, but it gives up the hardware listen-only mode.
- **TCAN1044V doesn't fit this board** without adding a 5 V supply.

---

## Proposed BOM changes (summary for T)
| Ref | Current → proposed | LCSC # | Class | Drop-in | Why |
|---|---|---|---|---|---|
| D3 | FMS SMBJ24A → **MDD SMBJ24A** | C123819 | Ext. (unchanged) | Yes | Current part has 0 stock |
| D5 | Everlight yellow → **KENTO KT-0603W white** (or KT-0603R red, C2286) | C2290 | **Basic** | Yes | 0 stock; saves an extended fee |
| U1 | STM32G0B1CBT6: **no drop-in available** | — | — | — | 0 stock: re-check, consign, or move to UFQFPN48 CEU6 (C2829190, layout change) |
| C10, C11 | 30 pF → **20 pF C0G** | C1648 | Basic | Yes | HSE start-up margin (step 7) |
| Q1 | AO3400A → **AO3422** | C37130 | Ext. (+1 fee) | Yes | 55 V, ≤ 200 mΩ at 2.5 V |
| F1 | BSMD1206-050-30V → **mSMD050-60V** (1812) *or* **0466.500NRHF** (1206 fuse) | C70113 / C151133 | Ext. (unchanged) | 1812: no / 1206 fuse: yes | 60–63 V rating |
| R1 | 1k → **4.7k** | C23162 | Basic | Yes | D4 current about 0.15 mA |
| D7 (optional) | SS34 → SS36 | C16015 | Ext. (+1 fee) | Yes | 60 V flyback once Q1 is upgraded |
| BOM notes | Fix the MPN column for C3 (CL10A106MA8NRNC, 25 V) and the 100 nF line (YAGEO CC0603KRX7R9BB104) | — | — | — | Notes don't match the actual LCSC parts |
| U3/U5 | Keep SN65HVD230 | C12084 | Preferred | — | No FD needed |

No KiCad or BOM files were changed. These are proposals only.
