tristanlee85/canode/hardware/docs/renders/canode_board_iso_kicad.png

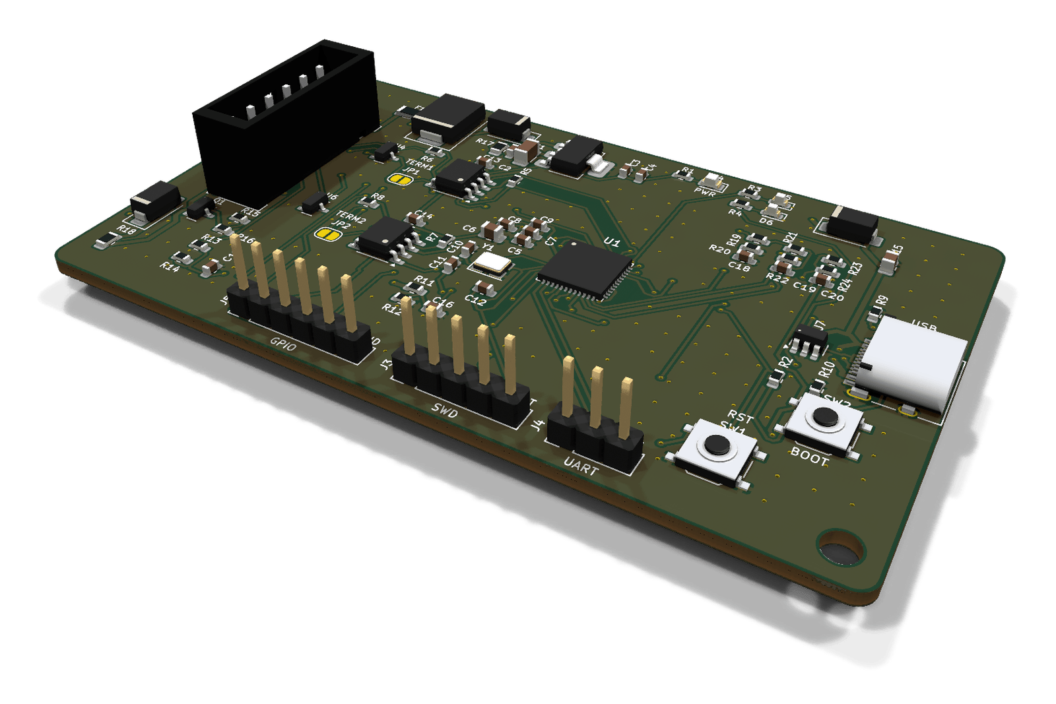
hardware/docs/renders/canode_board_iso_kicad.png
