tristanlee85/canode/hardware/fab/canode_BOM_JLC.csv

Comment | Designator | Footprint | LCSC Part # | Qty | MPN
10uF 50V | C1 | C_1206_3216Metric | C13585 | 1 | CL31A106KBHNNNE
100nF 50V | C2,C4,C5,C7,C9,C12,C13,C14,C16,C17,C18,C19,C20 | C_0603_1608Metric | C14663 | 13 | CL10B104KB8NNNC
10uF | C3 | C_0603_1608Metric | C96446 | 1 | CL10A106MQ8NNNC
4.7uF | C6,C15 | C_0805_2012Metric | C1779 | 2 | CL21A475KAQNNNE
1uF | C8 | C_0603_1608Metric | C15849 | 1 | CL10A105KB8NNNC
20pF | C10,C11 | C_0603_1608Metric | C1648 | 2 | CL10C200JB8NNNC
SS36 | D1,D2,D7 | D_SMA | C16015 | 3 | SS36
SMCJ33A | D3 | D_SMC | C135162 | 1 | SMCJ33A-13-F (Diodes Inc)
Green | D4 | LED_0805_2012Metric | C2297 | 1 | Green 0805 LED
Yellow | D5 | LED_0603_1608Metric | C2287 | 1 | KT-0603Y
Red | D6 | LED_0603_1608Metric | C2286 | 1 | Red 0603 LED
500mA PTC | F1 | Fuse_1206_3216Metric | C883126 | 1 | BSMD1206-050-30V
USB-C | J1 | USB_C_Receptacle_HRO_TYPE-C-31-M-12 | C165948 | 1 | HRO TYPE-C-31-M-12
AO3422 | Q1 | SOT-23 | C37130 | 1 | AO3422
4.7k | R1 | R_0603_1608Metric | C23162 | 1 | 0603 1% resistor
1k | R2,R3,R4 | R_0603_1608Metric | C21190 | 3 | 0603 1% resistor
10k | R5,R7,R12,R14,R20,R22,R23,R24 | R_0603_1608Metric | C25804 | 8 | 0603 1% resistor
120R | R6,R8 | R_0603_1608Metric | C22787 | 2 | 0603 1% resistor
5.1k | R9,R10 | R_0603_1608Metric | C23186 | 2 | 0603 1% resistor
100k | R11,R13,R16,R19,R21 | R_0603_1608Metric | C25803 | 5 | 0603 1% resistor
100R | R15 | R_0603_1608Metric | C22775 | 1 | 0603 1% resistor
10R | R17 | R_0805_2012Metric | C17415 | 1 | 0805W8F100JT5E
2.2R | R18 | R_0805_2012Metric | C17521 | 1 | 0805W8F220KT5E
RESET | SW1,SW2 | SW_Push_1P1T_XKB_TS-1187A | C318884 | 2 | TS-1187A-B-A-B
STM32G0B1CEU6 | U1 | QFN-48-1EP_7x7mm_P0.5mm_EP5.6x5.6mm | C2829190 | 1 | STM32G0B1CEU6
TPS7B6933QDCYRQ1 | U2 | SOT-223-3_TabPin2 | C108471 | 1 | TPS7B6933QDCYRQ1
SN65HVD230DR | U3,U5 | SOIC-8_3.9x4.9mm_P1.27mm | C12084 | 2 | SN65HVD230DR
NUP2105L | U4,U6 | SOT-23 | C14486 | 2 | NUP2105LT1G
USBLC6-2SC6 | U7 | SOT-23-6 | C7519 | 1 | USBLC6-2SC6
12MHz | Y1 | Crystal_SMD_3225-4Pin_3.2x2.5mm | C9002 | 1 | X322512MSB4SI (20pF CL)
