tristanlee85/canode/hardware/3dmodels/Molex_Micro-Fit_3.0_43045-1212_2x06_P3.00mm_Vertical.step

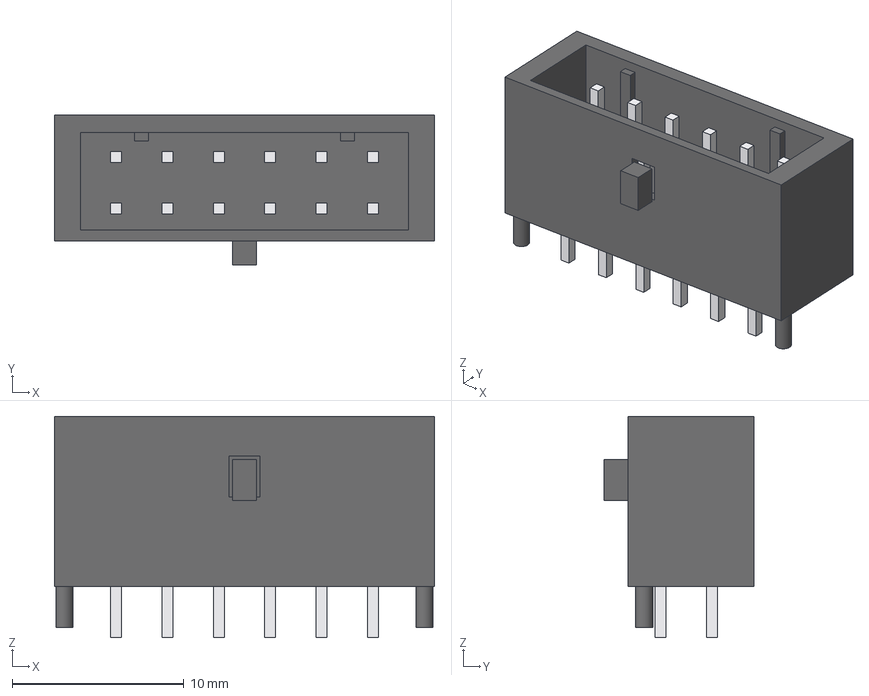
[picture p13: CAD file, 2026-11-09]
hardware/3dmodels/Molex_Micro-Fit_3.0_43045-1212_2x06_P3.00mm_Vertical.step
22.1 x 8.77 x 12.9 mm
housing
pins
pegs
