tristanlee85/canode/hardware/enclosure/out/canode_enclosure_base.step

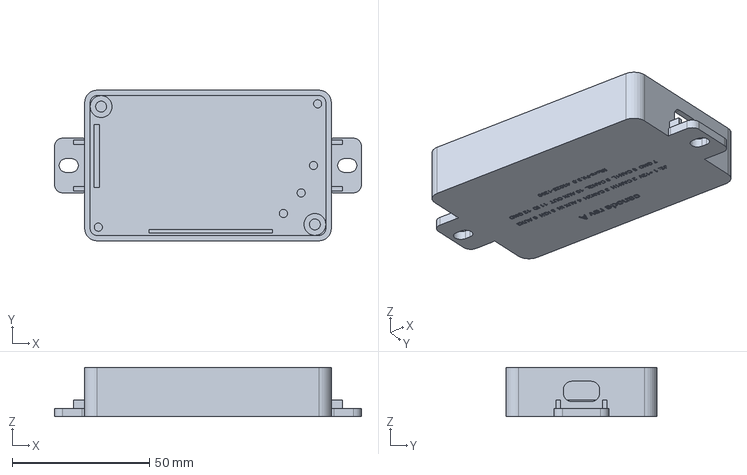
[picture p14: CAD file, 2026-11-09]
hardware/enclosure/out/canode_enclosure_base.step
112.0 x 55.0 x 18.0 mm
