tristanlee85/canode/hardware/3dmodels/Molex_Micro-Fit_3.0_43025-1200_plug_mated.step

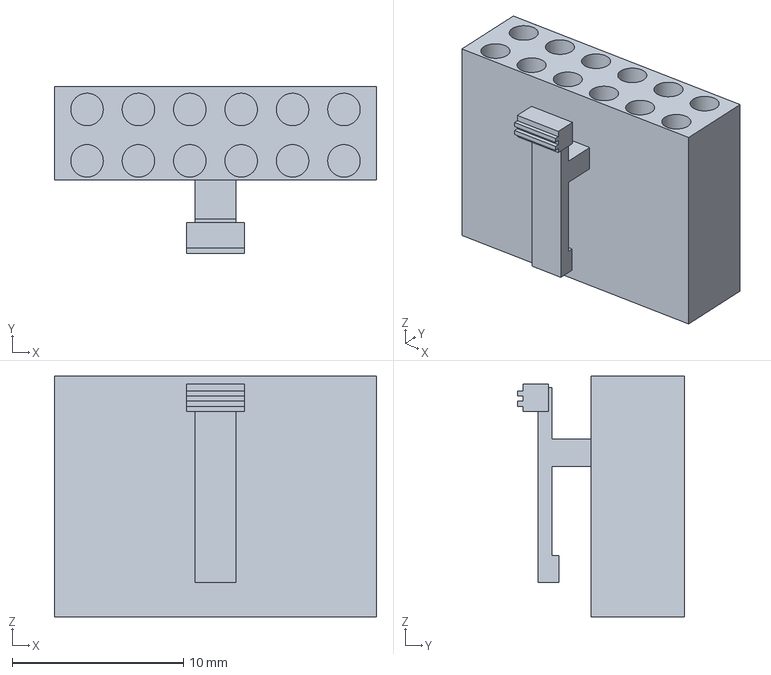
[picture p15: CAD file, 2026-11-09]
hardware/3dmodels/Molex_Micro-Fit_3.0_43025-1200_plug_mated.step
18.8 x 9.73 x 14.1 mm
