tristanlee85/canode/hardware/enclosure/out/canode_enclosure_lid.step

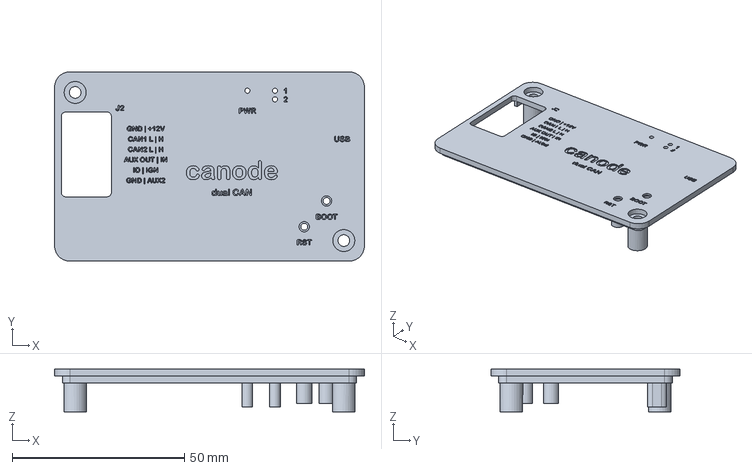
[picture p16: CAD file, 2026-11-09]
hardware/enclosure/out/canode_enclosure_lid.step
90.0 x 55.0 x 12.4 mm
