tristanlee85/canode/hardware/3dmodels/SW_Push_1P1T_XKB_TS-1187A.step

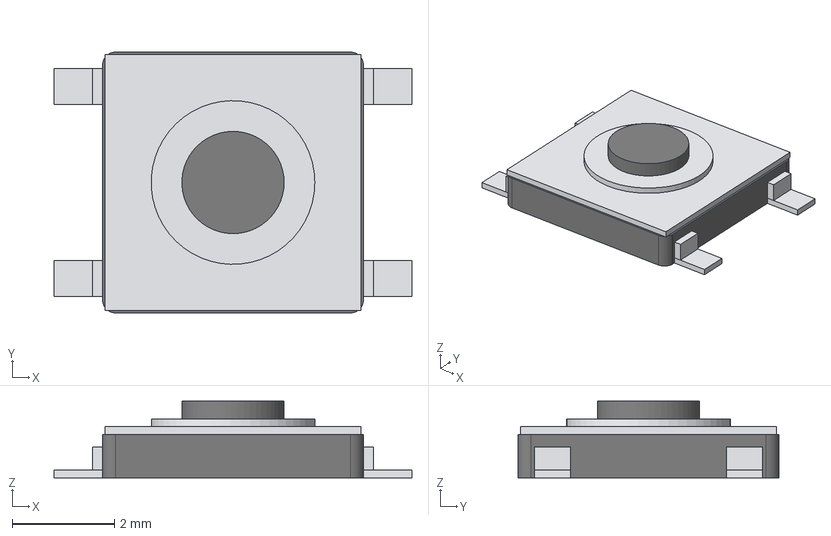
[picture p17: CAD file, 2026-11-09]
hardware/3dmodels/SW_Push_1P1T_XKB_TS-1187A.step
7.00 x 5.10 x 1.50 mm
base
cover
plunger
leads
