tristanlee85/canode/hardware/3dmodels/USB_C_Receptacle_HRO_TYPE-C-31-M-12.step

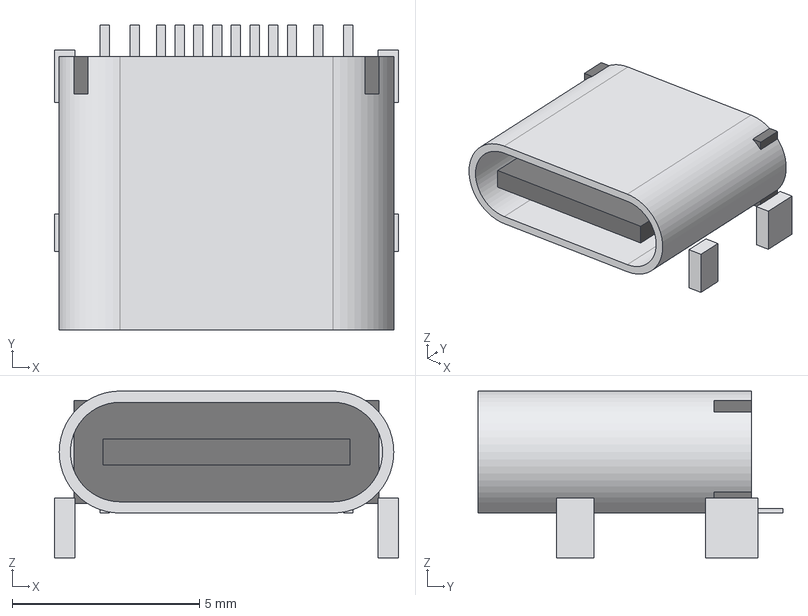
[picture p18: CAD file, 2026-11-09]
hardware/3dmodels/USB_C_Receptacle_HRO_TYPE-C-31-M-12.step
9.19 x 8.14 x 4.46 mm
tongue
legs
contacts
