tristanlee85/canode/validation/sim/out/sim1_reverse_battery.png

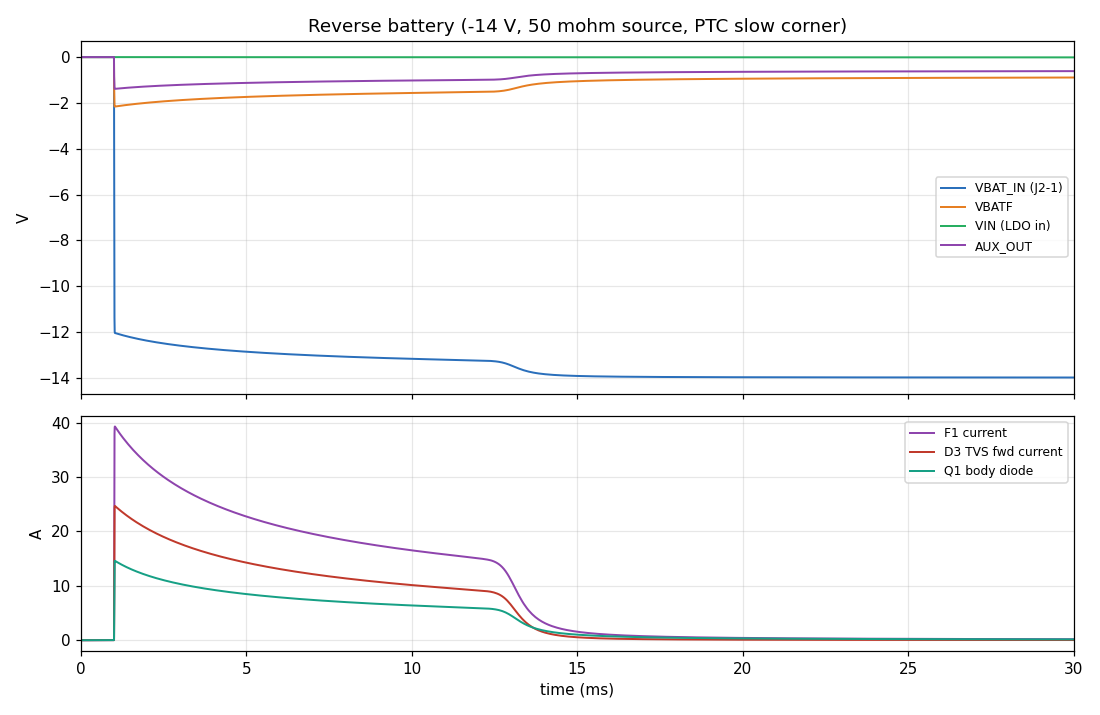
validation/sim/out/sim1_reverse_battery.png
