tristanlee85/canode/validation/sim/out/sim2_loaddump_suppressed.png

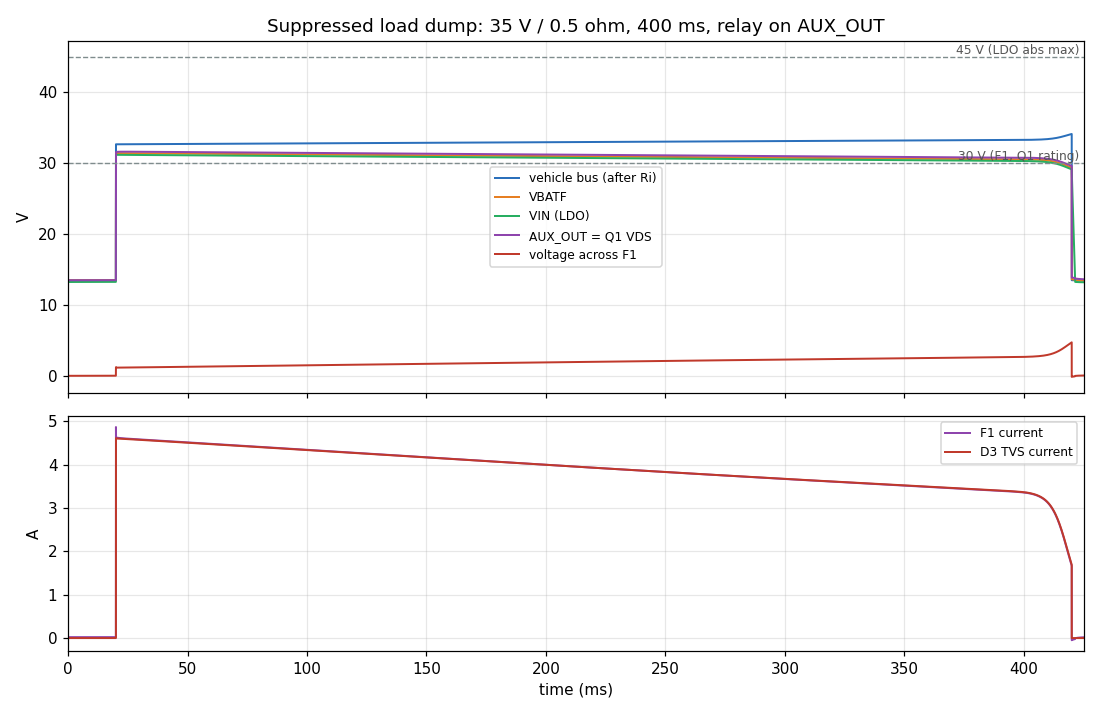
validation/sim/out/sim2_loaddump_suppressed.png
