tristanlee85/canode/validation/sim/out/sim2_loaddump_unsuppressed.png

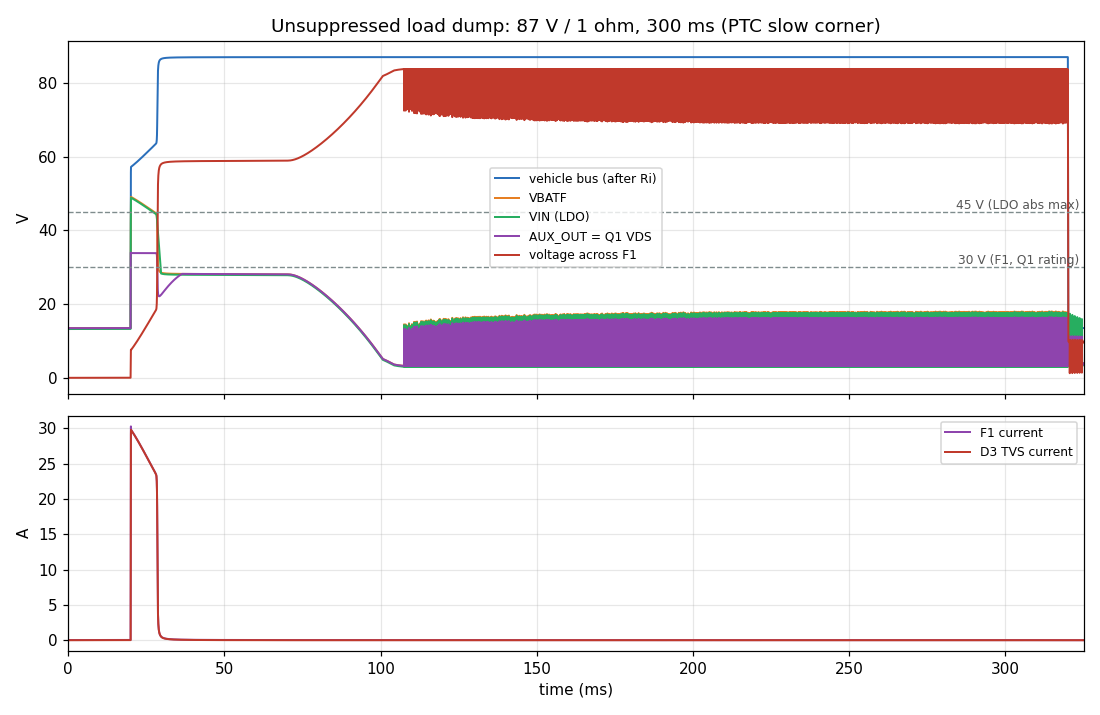
validation/sim/out/sim2_loaddump_unsuppressed.png
