tristanlee85/canode/validation/sim/out/sim3_vbat_divider.png

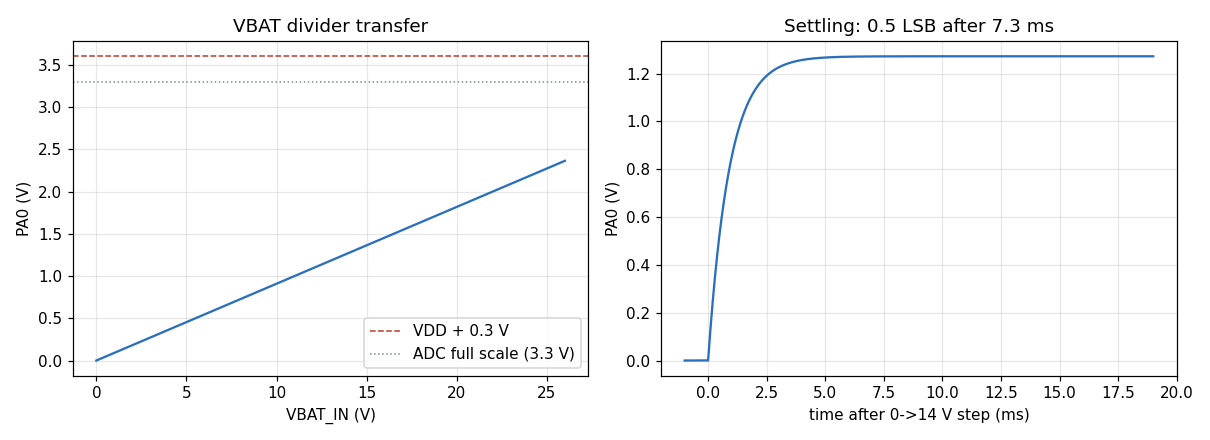
validation/sim/out/sim3_vbat_divider.png
