tristanlee85/canode/validation/sim/out/sim4_ldo_startup.png

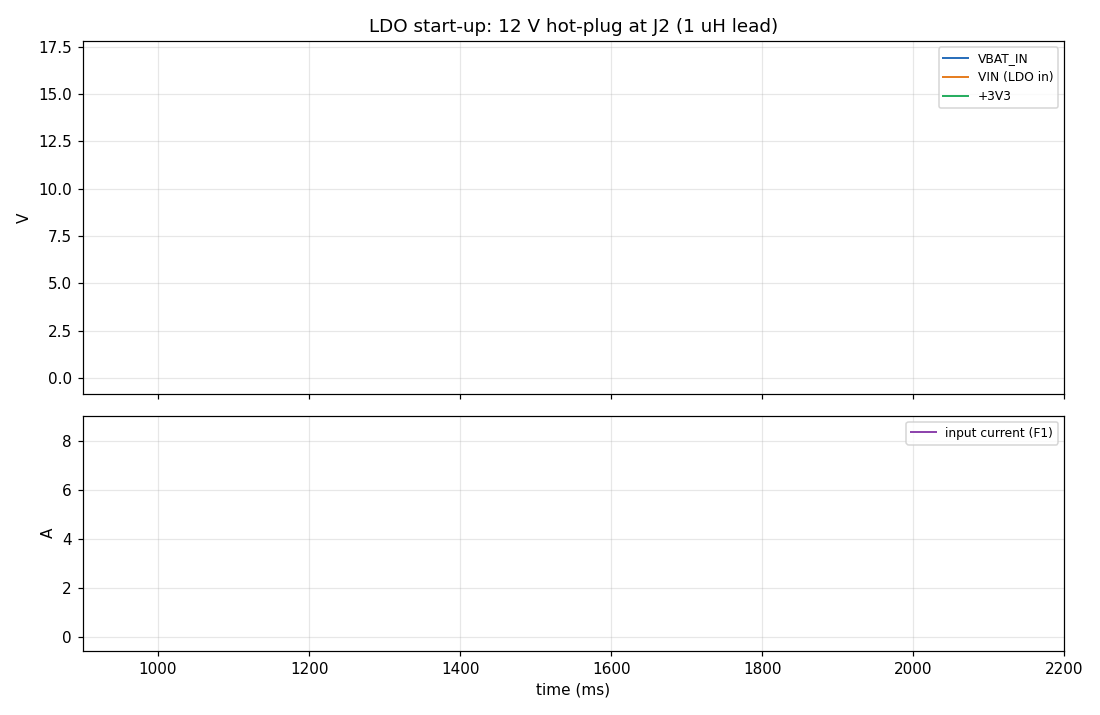
validation/sim/out/sim4_ldo_startup.png
