tristanlee85/canode/hardware/docs/canode_schematic.pdf

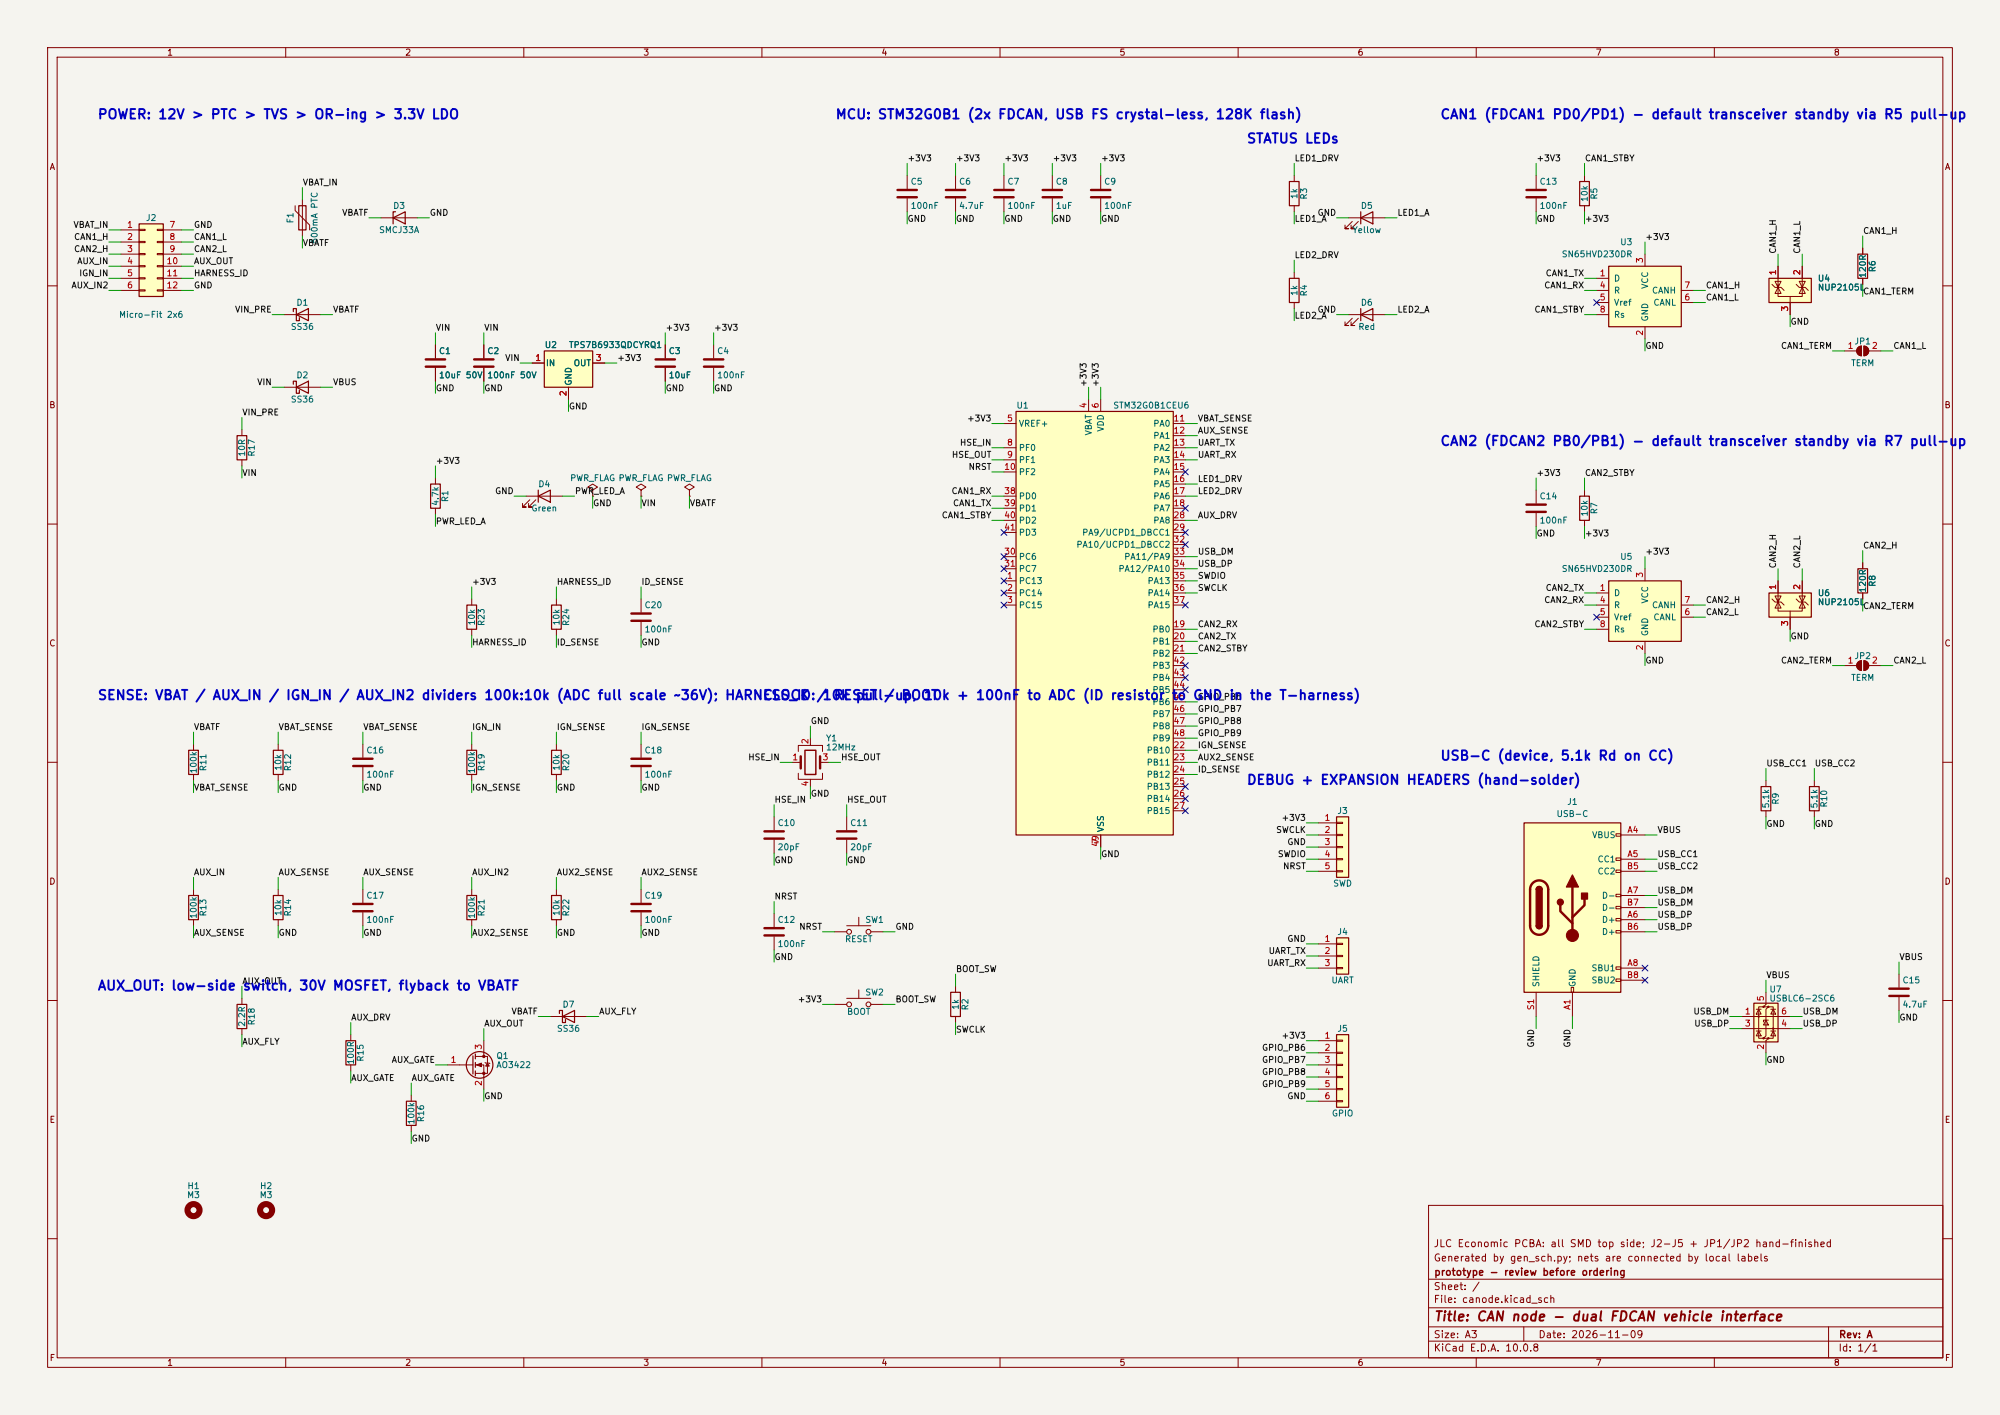
[picture p25: page 1]

AUX_INPOWER: 12V > PTC > TVS > OR-ing > 3.3V LDO

CAN1 (FDCAN1 PD0/PD1) - default transceiver standby via R5 pull-up

CAN2 (FDCAN2 PB0/PB1) - default transceiver standby via R7 pull-up

USB-C (device, 5.1k Rd on CC)

DEBUG + EXPANSION HEADERS (hand-solder)

JLC Economic PCBA: all SMD top side; J2-J5 + JP1/JP2 hand-finished
Generated by gen_sch.py; nets are connected by local labels
prototype - review before ordering
Sheet: /
File: canode.kicad_sch
Title: CAN node - dual FDCAN vehicle interface

Size: A3 | Rev: A | F Date: 2026-11-09
KiCad E.D.A. 10.0.8 | Id: 1/1
