tristanlee85/canode/hardware/kicad/canode.kicad_pcb

## KiCad design hardware/kicad/canode.kicad_pcb (2026-11-09)

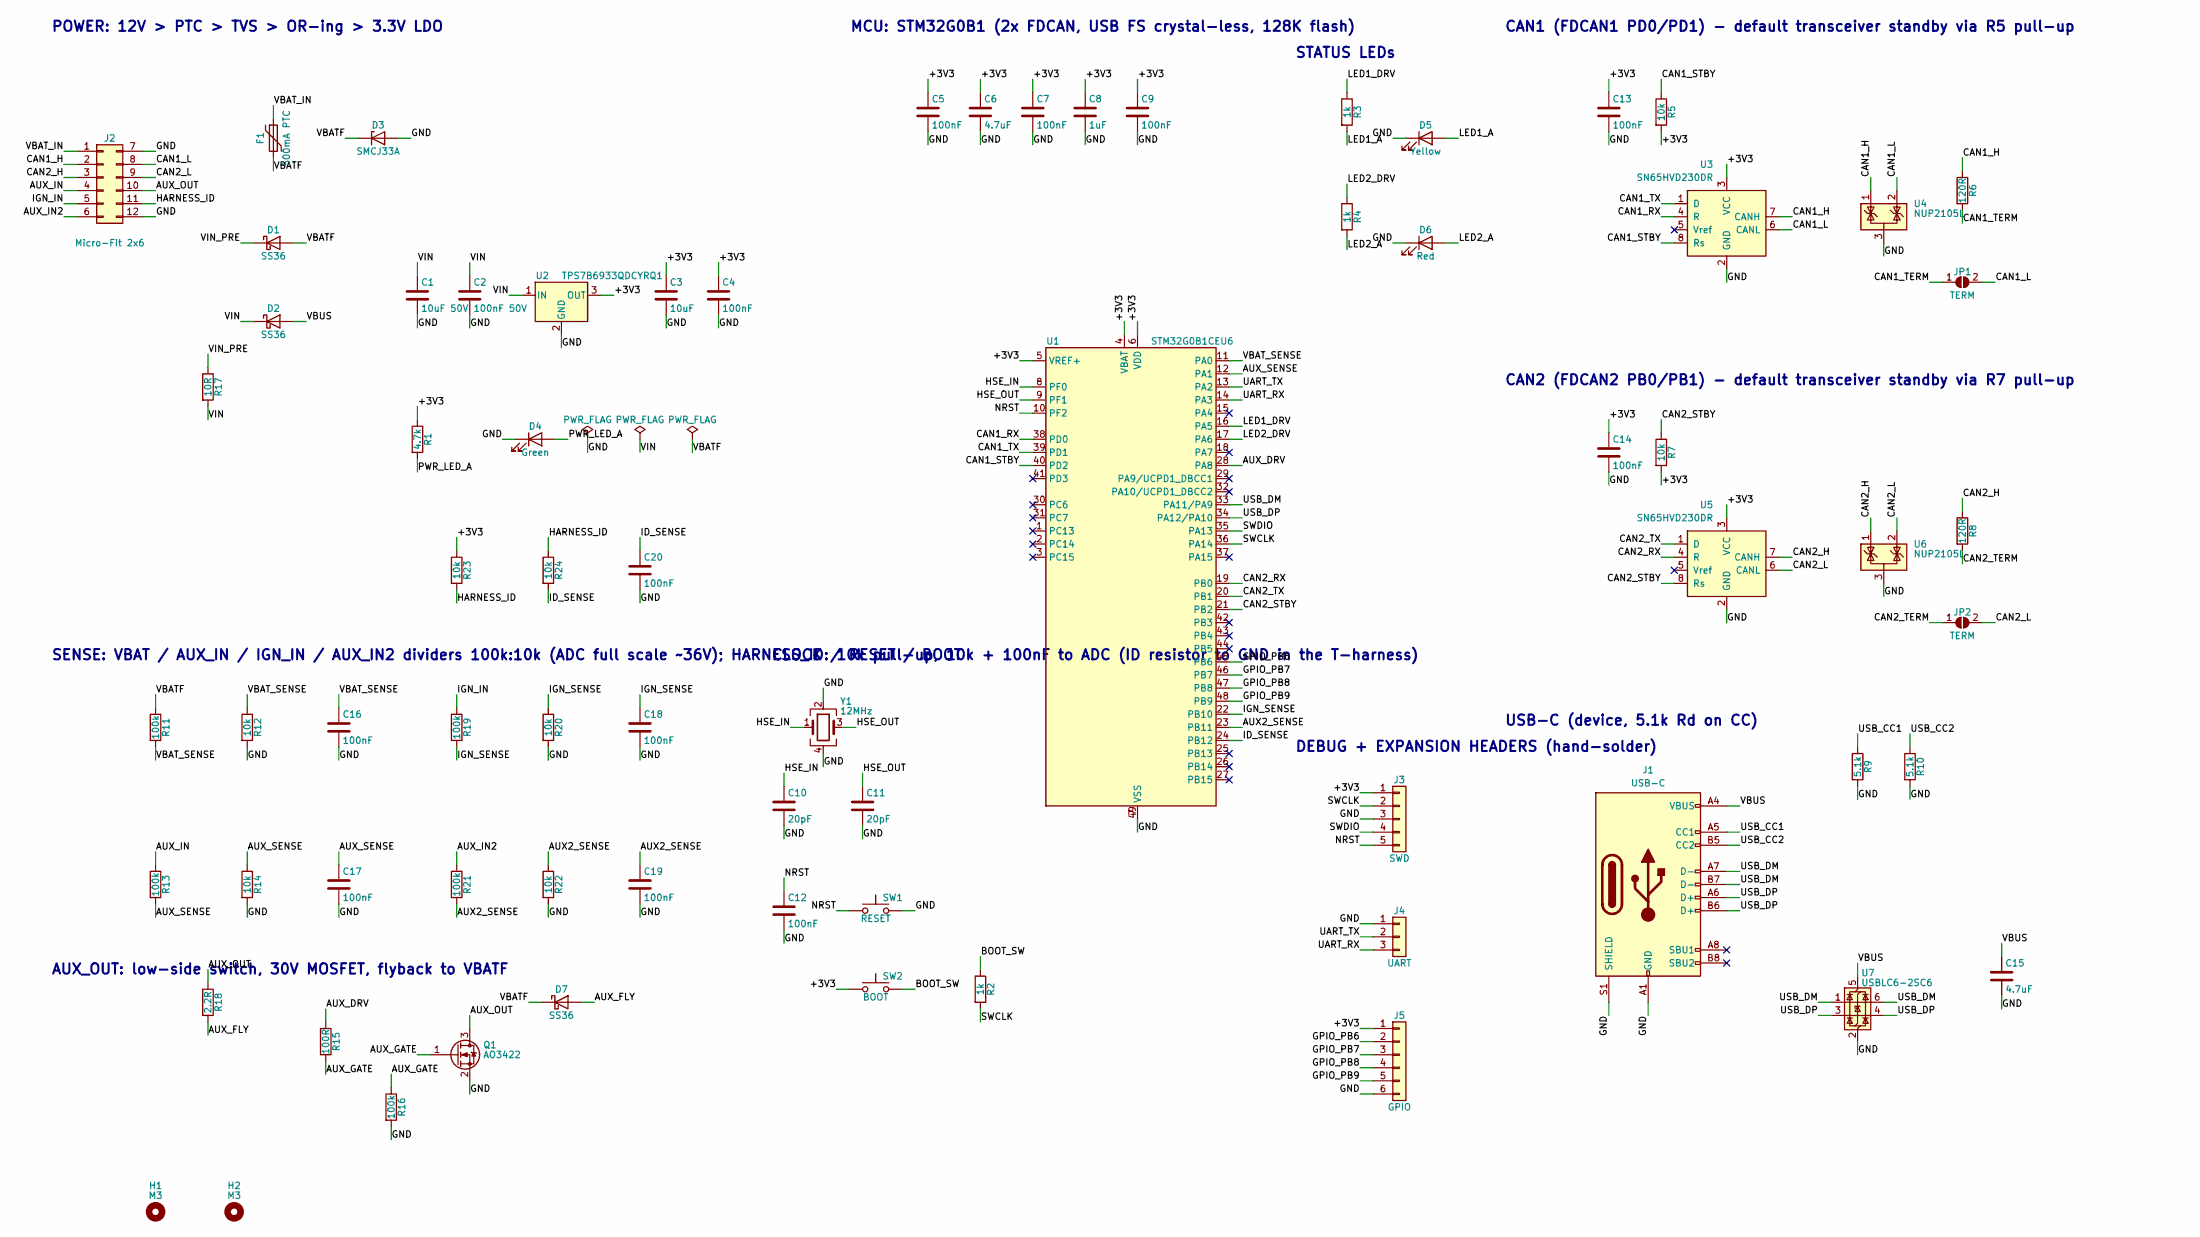
[picture p26: schematic canode.kicad_sch, CAN node - dual FDCAN vehicle interface]

Parts:
C1: 10uF 50V; C_1206_3216Metric; MPN CL31A106KBHNNNE; LCSC C13585
C2: 100nF 50V; C_0603_1608Metric; MPN CL10B104KB8NNNC; LCSC C14663
C3: 10uF; C_0603_1608Metric; MPN CL10A106MQ8NNNC; LCSC C96446
C4, C5, C7, C9, C12, C13, C14, C16, C17, C18, C19, C20: 100nF; C_0603_1608Metric; MPN CL10B104KB8NNNC; LCSC C14663
C6, C15: 4.7uF; C_0805_2012Metric; MPN CL21A475KAQNNNE; LCSC C1779
C8: 1uF; C_0603_1608Metric; MPN CL10A105KB8NNNC; LCSC C15849
C10, C11: 20pF; C_0603_1608Metric; MPN CL10C200JB8NNNC; LCSC C1648
D1, D2, D7: SS36; D_SMA; MPN SS36; LCSC C16015
D3: SMCJ33A; D_SMC; MPN SMCJ33A-13-F (Diodes Inc); LCSC C135162
D4: Green; LED_0805_2012Metric; MPN Green 0805 LED; LCSC C2297
D5: Yellow; LED_0603_1608Metric; MPN KT-0603Y; LCSC C2287
D6: Red; LED_0603_1608Metric; MPN Red 0603 LED; LCSC C2286
F1: 500mA PTC; Fuse_1206_3216Metric; MPN BSMD1206-050-30V; LCSC C883126
H1, H2: M3; MountingHole_3.2mm_M3; JLC hand-solder / not assembled
J1: USB-C; USB_C_Receptacle_HRO_TYPE-C-31-M-12; MPN HRO TYPE-C-31-M-12; LCSC C165948
J2: Micro-Fit 2x6; Molex_Micro-Fit_3.0_43045-1212_2x06_P3.00mm_Vertical; MPN Molex 43045-1212; JLC hand-solder / not assembled
J3: SWD; PinHeader_1x05_P2.54mm_Vertical; MPN 1x5 2.54mm header; JLC hand-solder / not assembled
J4: UART; PinHeader_1x03_P2.54mm_Vertical; MPN 1x3 2.54mm header; JLC hand-solder / not assembled
J5: GPIO; PinHeader_1x06_P2.54mm_Vertical; MPN 1x6 2.54mm header; JLC hand-solder / not assembled
JP1, JP2: TERM; SolderJumper-2_P1.3mm_Open_RoundedPad1.0x1.5mm; MPN solder jumper (bridge = 120R terminatio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; JLC hand-solder / not assembled
Q1: AO3422; SOT-23; MPN AO3422; LCSC C37130
R1: 4.7k; R_0603_1608Metric; MPN 0603 1% resistor; LCSC C23162
R2, R3, R4: 1k; R_0603_1608Metric; MPN 0603 1% resistor; LCSC C21190
R5, R7, R12, R14, R20, R22, R23, R24: 10k; R_0603_1608Metric; MPN 0603 1% resistor; LCSC C25804
R6, R8: 120R; R_0603_1608Metric; MPN 0603 1% resistor; LCSC C22787
R9, R10: 5.1k; R_0603_1608Metric; MPN 0603 1% resistor; LCSC C23186
R11, R13, R16, R19, R21: 100k; R_0603_1608Metric; MPN 0603 1% resistor; LCSC C25803
R15: 100R; R_0603_1608Metric; MPN 0603 1% resistor; LCSC C22775
R17: 10R; R_0805_2012Metric; MPN 0805W8F100JT5E; LCSC C17415
R18: 2.2R; R_0805_2012Metric; MPN 0805W8F220KT5E; LCSC C17521
SW1: RESET; SW_Push_1P1T_XKB_TS-1187A; MPN TS-1187A-B-A-B; LCSC C318884
SW2: BOOT; SW_Push_1P1T_XKB_TS-1187A; MPN TS-1187A-B-A-B; LCSC C318884
U1: STM32G0B1CEU6; QFN-48-1EP_7x7mm_P0.5mm_EP5.6x5.6mm; MPN STM32G0B1CEU6; LCSC C2829190
U2: TPS7B6933QDCYRQ1; SOT-223-3_TabPin2; MPN TPS7B6933QDCYRQ1; LCSC C108471
U3, U5: SN65HVD230DR; SOIC-8_3.9x4.9mm_P1.27mm; MPN SN65HVD230DR; LCSC C12084
U4, U6: NUP2105L; SOT-23; MPN NUP2105LT1G; LCSC C14486
U7: USBLC6-2SC6; SOT-23-6; MPN USBLC6-2SC6; LCSC C7519
Y1: 12MHz; Crystal_SMD_3225-4Pin_3.2x2.5mm; MPN X322512MSB4SI (20pF CL); LCSC C9002

Connections:
/+3V3: C3.1, C4.1, C5.1, C6.1, C7.1, C8.1, C9.1, C13.1, C14.1, J3.1, J5.1, R1.1, R5.2, R7.2, R23.1, SW2.1, U1.4 (VBAT), U1.5 (VREF+), U1.6 (VDD), U2.3 (OUT), U3.3 (VCC), U5.3 (VCC)
/AUX2_SENSE: C19.1, R21.2, R22.1, U1.23 (PB11)
/AUX_DRV: R15.1, U1.28 (PA8)
/AUX_FLY: D7.2 (A), R18.2
/AUX_GATE: Q1.1 (G), R15.2, R16.1
/AUX_IN: J2.4, R13.1
/AUX_IN2: J2.6, R21.1
/AUX_OUT: J2.10, Q1.3 (D), R18.1
/AUX_SENSE: C17.1, R13.2, R14.1, U1.12 (PA1)
/BOOT_SW: R2.1, SW2.2
/CAN1_H: J2.2, R6.1, U3.7 (CANH), U4.1 (K)
/CAN1_L: J2.8, JP1.2 (B), U3.6 (CANL), U4.2 (K)
/CAN1_RX: U1.38 (PD0), U3.4 (R)
/CAN1_STBY: R5.1, U1.40 (PD2), U3.8 (Rs)
/CAN1_TERM: JP1.1 (A), R6.2
/CAN1_TX: U1.39 (PD1), U3.1 (D)
/CAN2_H: J2.3, R8.1, U5.7 (CANH), U6.1 (K)
/CAN2_L: J2.9, JP2.2 (B), U5.6 (CANL), U6.2 (K)
/CAN2_RX: U1.19 (PB0), U5.4 (R)
/CAN2_STBY: R7.1, U1.21 (PB2), U5.8 (Rs)
/CAN2_TERM: JP2.1 (A), R8.2
/CAN2_TX: U1.20 (PB1), U5.1 (D)
/GND: C1.2, C2.2, C3.2, C4.2, C5.2, C6.2, C7.2, C8.2, C9.2, C10.2, C11.2, C12.2, C13.2, C14.2, C15.2, C16.2, C17.2, C18.2, C19.2, C20.2, D3.2 (A), D4.1 (K), D5.1 (K), D6.1 (K), J1.A1 (GND), J1.A12 (GND), J1.B1 (GND), J1.B12 (GND), J1.S1 (SHIELD), J2.7, J2.12, J3.3, J4.1, J5.6, Q1.2 (S), R9.2, R10.2, R12.2, R14.2, R16.2, R20.2, R22.2, SW1.2, U1.7 (VSS), U1.49 (VSS), U2.2 (GND), U3.2 (GND), U4.3 (A), U5.2 (GND), U6.3 (A), U7.2 (GND), Y1.2, Y1.4
/GPIO_PB6: J5.2, U1.45 (PB6)
/GPIO_PB7: J5.3, U1.46 (PB7)
/GPIO_PB8: J5.4, U1.47 (PB8)
/GPIO_PB9: J5.5, U1.48 (PB9)
/HARNESS_ID: J2.11, R23.2, R24.1
/HSE_IN: C10.1, U1.8 (PF0), Y1.1
/HSE_OUT: C11.1, U1.9 (PF1), Y1.3
/ID_SENSE: C20.1, R24.2, U1.24 (PB12)
/IGN_IN: J2.5, R19.1
/IGN_SENSE: C18.1, R19.2, R20.1, U1.22 (PB10)
/LED1_A: D5.2 (A), R3.2
/LED1_DRV: R3.1, U1.16 (PA5)
/LED2_A: D6.2 (A), R4.2
/LED2_DRV: R4.1, U1.17 (PA6)
/NRST: C12.1, J3.5, SW1.1, U1.10 (PF2)
/PWR_LED_A: D4.2 (A), R1.2
/SWCLK: J3.2, R2.2, U1.36 (PA14)
/SWDIO: J3.4, U1.35 (PA13)
/UART_RX: J4.3, U1.14 (PA3)
/UART_TX: J4.2, U1.13 (PA2)
/USB_CC1: J1.A5 (CC1), R9.1
/USB_CC2: J1.B5 (CC2), R10.1
/USB_DM: J1.A7 (D-), J1.B7 (D-), U1.33 (PA11/PA9), U7.1 (I/O1), U7.6 (I/O1)
/USB_DP: J1.A6 (D+), J1.B6 (D+), U1.34 (PA12/PA10), U7.3 (I/O2), U7.4 (I/O2)
/VBATF: D1.2 (A), D3.1 (K), D7.1 (K), F1.2, R11.1
/VBAT_IN: F1.1, J2.1
/VBAT_SENSE: C16.1, R11.2, R12.1, U1.11 (PA0)
/VBUS: C15.1, D2.2 (A), J1.A4 (VBUS), J1.A9 (VBUS), J1.B4 (VBUS), J1.B9 (VBUS), U7.5 (VBUS)
/VIN: C1.1, C2.1, D2.1 (K), R17.2, U2.1 (IN)
/VIN_PRE: D1.1 (K), R17.1

Notes on the sheet:
CAN1 (FDCAN1 PD0/PD1) - default transceiver standby via R5 pull-up
CAN2 (FDCAN2 PB0/PB1) - default transceiver standby via R7 pull-up
STATUS LEDs
AUX_OUT: low-side switch, 30V MOSFET, flyback to VBATF
DEBUG + EXPANSION HEADERS (hand-solder)
SENSE: VBAT / AUX_IN / IGN_IN / AUX_IN2 dividers 100k:10k (ADC full scale ~36V); HARNESS_ID: 10k pull-up, 10k + 100nF to ADC (ID resistor to GND in the T-harness)
POWER: 12V > PTC > TVS > OR-ing > 3.3V LDO
USB-C (device, 5.1k Rd on CC)
MCU: STM32G0B1 (2x FDCAN, USB FS crystal-less, 128K flash)
CLOCK / RESET / BOOT

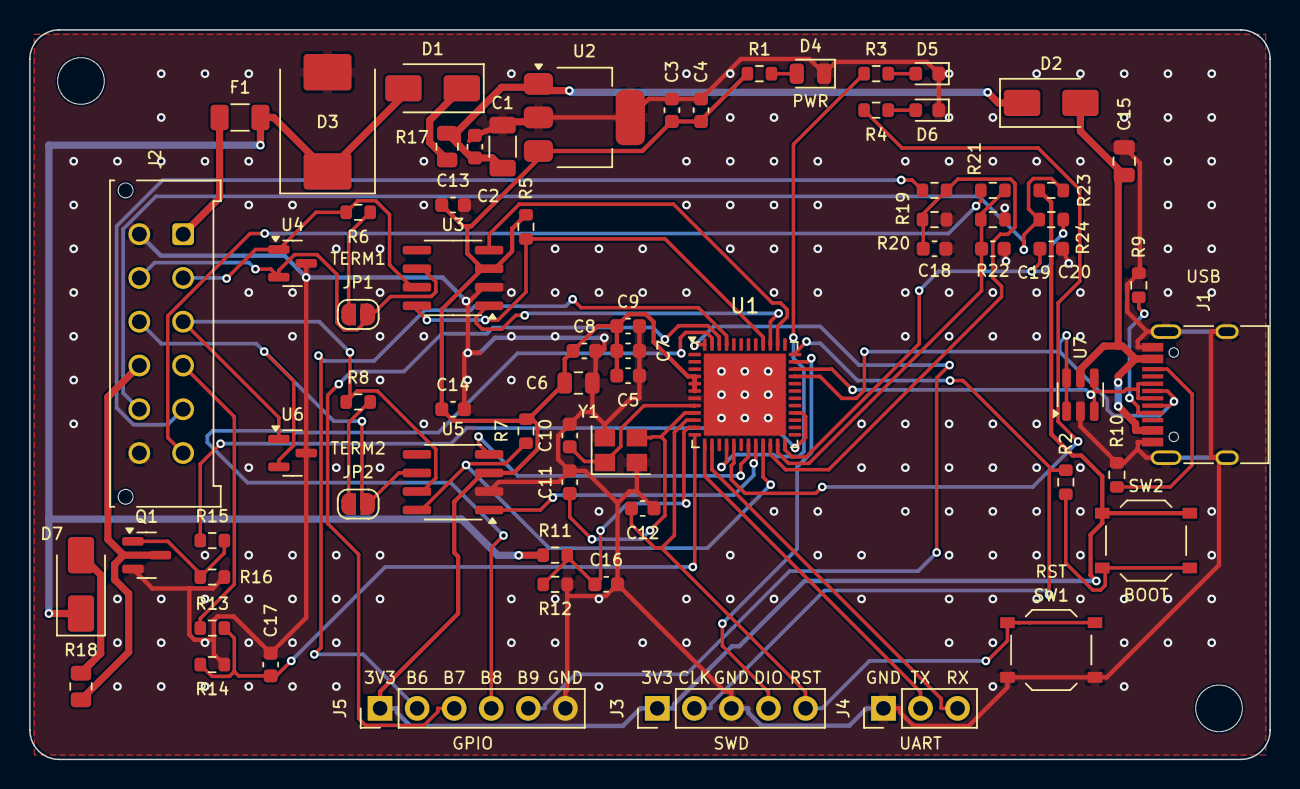
[picture p27: board canode.kicad_pcb from above]

Board: 2 copper layers, 85.0 x 50.0 mm, 72 parts (0 on the bottom side), 53 nets.
