tristanlee85/canode/(commit log)

2026-11-09 Rev A: dual-CAN STM32G0B1 node - KiCad project, JLC outputs, validation tooling
    - KiCad 7 project (schematic, autorouted 2-layer board, project symbol lib)
    - JLC Economic PCBA outputs: gerbers, BOM, CPL, hand-solder list
    - validation/check_pins.py: MCU pinout vs ST STM32_open_pin_data (passes 28/28)
    - hardware/scripts/jlc_fab.py + Makefile targets (pins/erc/drc/fab)
    - tools/canlog: STN adapter CAN logger/diff console with offline tests
    - CLAUDE.md, validation plan, macOS setup script
    Claude-Session: https://claude.ai/code/session_01PiupzZ5XeGVrRRUKF1czqB
    [canode-B_Cu.gbl, canode-B_Mask.gbs, canode-B_Paste.gbp, canode-B_Silkscreen.gbo, canode-Edge_Cuts.gm1, canode-F_Cu.gtl, canode-F_Mask.gts, canode-F_Paste.gtp]
2026-11-09 Rev A: KiCad 10, DRC fixes, UFQFPN-48 MCU, firmware, sims, enclosure, renders
    - Upgrade project to KiCad 10; sync board fields/nets to the schematic
    (DRC 0 errors, 0 unconnected, parity clean; ERC 0 errors)
    - U1 -> STM32G0B1CEU6 (UFQFPN-48; LQFP part out of stock), local reroute
    - Stock/robustness swaps: D3 maker, D5 LED, 20 pF HSE caps, AO3422 Q1,
    SS36 D1/D2/D7
    - Firmware: CMake + HAL + TinyUSB, listen-only by default, host unit tests
    - ngspice power-input simulations (flags D3 SMBJ24A in suppressed load dump)
    - build123d enclosure (MJF PA12) and Blender board/enclosure renders
    - Validation reports for steps 1-9; README rewrite
    Cl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
    [Molex_Micro-Fit_3.0_43025-0800_plug_mated.step, Molex_Micro-Fit_3.0_43045-0812_2x04_P3.00mm_Vertical.step, SW_Push_1P1T_XKB_TS-1187A.step, USB_C_Receptacle_HRO_TYPE-C-31-M-12.step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]
2026-11-09 Firmware: Stop 1 sleep with wake on CAN1, CAN2 or UART
    - lib/power.c: host-tested sleep policy. Auto-sleep after 60 s with no
    frames and no console input; never while USB is mounted or once transmit
    has been enabled since boot (a wake only restores listen-only)
    - src/sleep.c: FDCANs stopped, Rs high (transceiver standby, receiver on),
    USB detached, Stop 1 with the low-power regulator. CAN1 wakes via EXTI0
    on PD0; CAN2 via COMP3 on PB0 (PD0/PB0 share EXTI line 0); UART RX on PA3
    - On wake: clocks restored, channels back in bus-monitoring mode
    - Shell: sleep [on|off|now|timeout <s>]; 1277 host checks pass
    - Untested on hardware
    C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
2026-11-09 Input protection for the 35 V suppressed load dump; dimmer power LED
    - D3 SMBJ24A -> SMCJ33A (1500 W SMC, 36.7 V min breakdown): no longer
    conducts in a 35 V suppressed load dump (was 16-49 J)
    - R17 10 ohm (D1 -> VIN) + C1 10 uF/50 V 1206 ahead of the LDO: pulse 2a
    peaks at ~29 V at the LDO (was 44 V)
    - R18 2.2 ohm in series with D7: reverse-battery current through Q1's
    body diode 14.6 A -> 0.74 A
    - R1 1k -> 4.7k: always-on power LED ~0.1-0.17 mA for sleep current
    - Board: D3/C1 footprints, R17/R18 placed, F1/D1 nudged, power nets
    re-routed with Freerouting; DRC 0 errors, 0 unconnected, parity clean
    - Sims: protection-update cases in run_all.py; report
    validation/reports/2026-11-09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
    [canode-B_Cu.gbl, canode-B_Mask.gbs, canode-B_Paste.gbp, canode-B_Silkscreen.gbo, canode-Edge_Cuts.gm1, canode-F_Cu.gtl, canode-F_Mask.gts, canode-F_Paste.gtp]
2026-11-09 Firmware: let a running gateway sleep and resume on wake
    T chose option (a): the gateway no longer blocks auto-sleep. Both
    gateway channels are armed for wake-up and come back in normal mode,
    so forwarding resumes by itself. Manual transmit (normal mode with the
    gateway off) still keeps the board awake. The since-boot TX latch is
    gone: wakes now restore what was running, so it had no purpose.
    Claude-Session: https://claude.ai/code/session_01PiupzY6NionorXbEaBxfLm
    [can_drv.c, can_drv.h, commands.c, main.c, sleep.c, sleep.h, test_power.c]
2026-11-09 Per-vehicle T-harness renders; capabilities list in README
    Three new Blender scenes (veh_ford, veh_gm, veh_bmw) show canode on an
    inline T-harness between a module and its factory connector. Housings
    are representative, not OEM copies. README gains a capabilities section
    (today vs hardware-ready) and an 'In the car' section with the T-harness
    wiring table and termination note. CLAUDE.md resume point updated.
    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
2026-11-09 J2 to 2x6 Micro-Fit for a universal pigtail; gateway placement docs
    T's direction: canode lives at each vehicle's CAN gateway, with one
    universal pigtail (J2 -> Deutsch DTM 12-way) and a T-harness per car.
    J2 grows from 43045-0812 (2x4) to 43045-1212 (2x6), same pin-1 spot:
    5 IGN_IN and 6 AUX_IN2 (0-36 V dividers, same as VBAT/AUX_IN),
    11 HARNESS_ID (10k pull-up, ID resistor in each T-harness), 12 GND.
    Nine new 0603s (all existing Basic part numbers); sense pins
    PB10/PB11/PB12 (ADC1_IN11/15/16). D7/R18 moved; local re-route with
    other copper locked, plus hand routes for VBATF, NRST, ID_SENSE and
    GND vias. Back silk, enclosure lid/legend/base label, 3D models,
    renders (vehicle scenes now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
    [Molex_Micro-Fit_3.0_43025-0800_plug_mated.step, Molex_Micro-Fit_3.0_43025-1200_plug_mated.step, Molex_Micro-Fit_3.0_43045-1212_2x06_P3.00mm_Vertical.step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]
2026-11-10 V2 plan: architecture overview and workstreams
    Planning only, no part choices. One intercepted bus plus two taps
    (four CAN channels), fail-safe bypass, stronger input protection,
    state and bulk storage, wireless, feature recall firmware model.
    CLAUDE.md step 5 points to it.
    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
2026-11-10 tools/canlog: fold in the truck-canbus-tools workbench
    Bring the pre-canode STN/OBDLink CAN debugging tools into the repo under
    tools/canlog/, isolated from the board but version-controlled alongside it.
    - canbus.py: shared core (frame parsing, adapter wrapper, ISO-TP, GMLAN/UDS)
    - cantool.py: active diagnostic read/write console (VIN, module discovery,
    DID reads, held GMLAN $AE device control). The one tool here that transmits;
    reads by default, arms explicitly, releases on exit.
    - canlog.py: upgraded from the trimmed monitor-only copy to the full workbench
    (guided feature tests, Bluetooth reconnect, .json findings, port auto-detect).
    - stn_protocols.json: protocol-number cache.
    - lo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
2026-11-10 tools/canlog: real recording of a canlog session (GIF + MP4)
    docs/canlog-session.gif and .mp4 show canlog.py running, not a mock-up: the
    2026-11-05 Silverado SW-CAN capture replayed at 1x through --replay in a
    pseudo-terminal, with the same keypresses at the same capture times as the
    original session's .marks (baseline, Headlight switch, High beams, custom Fog
    lights test). Rendered at 7x so the ~7 min session plays in ~1 min.
    The re-run reproduces the original results: 82 noise bits at baseline, and
    every finding on 0x1020C040. Keypress timing is within ~0.1-0.3 s of the
    original, so two tests also show a first-round "disagrees" note.
    docs/record_session.py regenerates the recording (agg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
